nottysukku/GrassKit_Rover/16_RaceCar_MotorDriver_Bluetooth_Audio/docs/audio_architecture.md

# Audio Engine Architecture & Synthesis Theory

This document details the real-time audio synthesis engine developed for the **STM32L073RZ** and **MAX98357A** Class-D amplifier.

---

## 1. Hardware Constraints on STM32L073RZ

The STM32L073RZ features an **ARM Cortex-M0+ core at 32 MHz** with **20 KB of SRAM** and no floating-point hardware (FPU).
These constraints make conventional approaches infeasible:
- Loading multi-megabyte MP3/WAV samples into RAM is impossible (RAM is only 20 KB).
- Floating-point `sin()` or DSP polynomial evaluations inside an audio interrupt would overload the 32 MHz CPU.

### Solution: Procedural Fixed-Point Audio Engine with I2S DMA
Our procedural synthesizer overcomes these limits:
1. **Zero-Overhead Streaming**: DMA1 Channel 5 handles continuous I2S transmission in circular ping-pong mode. The CPU only wakes up twice per buffer period (every 8 ms @ 16 kHz).
2. **Fixed-Point Arithmetic**: Frequency calculations and phase updates use 32-bit integer arithmetic with lookup tables.
3. **RAM Footprint**: The entire audio subsystem requires only **1024 bytes** of SRAM for the ping-pong DMA buffer.
4. **CPU Load**: Benchmark tests show synthesis takes less than **0.25 ms per 8 ms block**, representing **< 3.5% CPU utilization**!

---

## 2. Acoustic Physics of the V8 Engine Sound Model

The sound produced by an internal combustion engine is primarily governed by periodic high-pressure exhaust pulses exiting the cylinders:

$$\text{Combustion Frequency } F_c = \frac{\text{RPM}}{60} \times \frac{\text{Cylinders}}{2}$$

For a cross-plane V8 engine (8 cylinders), there are 4 combustion events per crankshaft revolution:
- **Idle (900 RPM)**: $F_c = \frac{900}{60} \times 4 = 60 \text{ Hz}$ (deep, throaty thrum)
- **Mid-Range (3600 RPM)**: $F_c = \frac{3600}{60} \times 4 = 240 \text{ Hz}$ (energetic roar)
- **Redline (7200 RPM)**: $F_c = \frac{7200}{60} \times 4 = 480 \text{ Hz}$ (high-pitched racing scream)

---

## 3. Multi-Layer Sound Synthesis Architecture

```text
  Engine Model (RPM, Throttle, Gear, Turbo, Rev Limit)
                      │
                      ▼
 ┌─────────────────────────────────────────────────────────┐
 │               Procedural Sound Generator                │
 │                                                         │
 │  [Phase Acc 1] ──► [256-point Asymmetric Pulse LUT]     │ (Fundamental Firing)
 │  [Phase Acc 2] ──► [Crankshaft Subharmonic 0.5x]        │ (Mechanical Thrum)
 │  [Phase Acc 3] ──► [Manifold Resonance 2x]              │ (Acoustic Ringing)
 │                                                         │
 │  [Linear Congruential Noise Gen]                        │
 │        ├── Load-dependent Intake Induction Roar         │ (Throttle Modulated)
 │        ├── Turbo Blow-Off Valve (BOV) Hiss              │ (Decay Envelope)
 │        └── Overrun Exhaust Crackles & Burble            │ (Anti-lag Pops)
 │                                                         │
 │  [Rev Limiter Gate] ──► 16 Hz Staccato Ignition Chop    │
 │  [Gear Shift Cut]   ──► 120 ms 75% Gain Dip             │
 └────────────────────────────┬────────────────────────────┘
                              │
                              ▼ 16-bit PCM @ 16 kHz
 ┌─────────────────────────────────────────────────────────┐
 │               I2S2 + DMA1 Double Buffer                 │
 │  Half-Buffer 0: 128 Stereo Samples                      │
 │  Half-Buffer 1: 128 Stereo Samples                      │
 └────────────────────────────┬────────────────────────────┘
                              │
                              ▼ Digital I2S Bus
                     MAX98357A Class-D Amp ──► Speaker
```

---

## 4. Special Sound Effects Implementation

1. **Intake Induction Roar**:
   As physical throttle increases from 0% to 100%, an envelope blends bandpass pseudorandom noise into the fundamental wave, replicating the deep acoustic growl of an open throttle body.
2. **Exhaust Overrun Pops (Anti-Lag)**:
   When throttle is rapidly closed from above 3500 RPM, unburned fuel entering the virtual exhaust manifold ignites, creating random, high-amplitude transient crackles (`Audio_TriggerOverrunPop()`).
3. **Turbo Blow-Off Valve (BOV)**:
   When boost pressure exceeds 0.45 bar and the throttle is released, a white-noise burst with an exponential low-pass filter decay is played to emulate a turbocharger wastegate/blow-off valve.
4. **Rev Limiter Bark**:
   When RPM reaches 7000 RPM, the fuel-cut algorithm gates the output at 16 Hz, producing the signature bouncing limiter bark heard on racing cars.
