nottysukku/GrassKit_Rover/17_Rover_MotorDriver_WiFi_ST67W61/docs/rbt01a_sheet_b_logic_wires.png

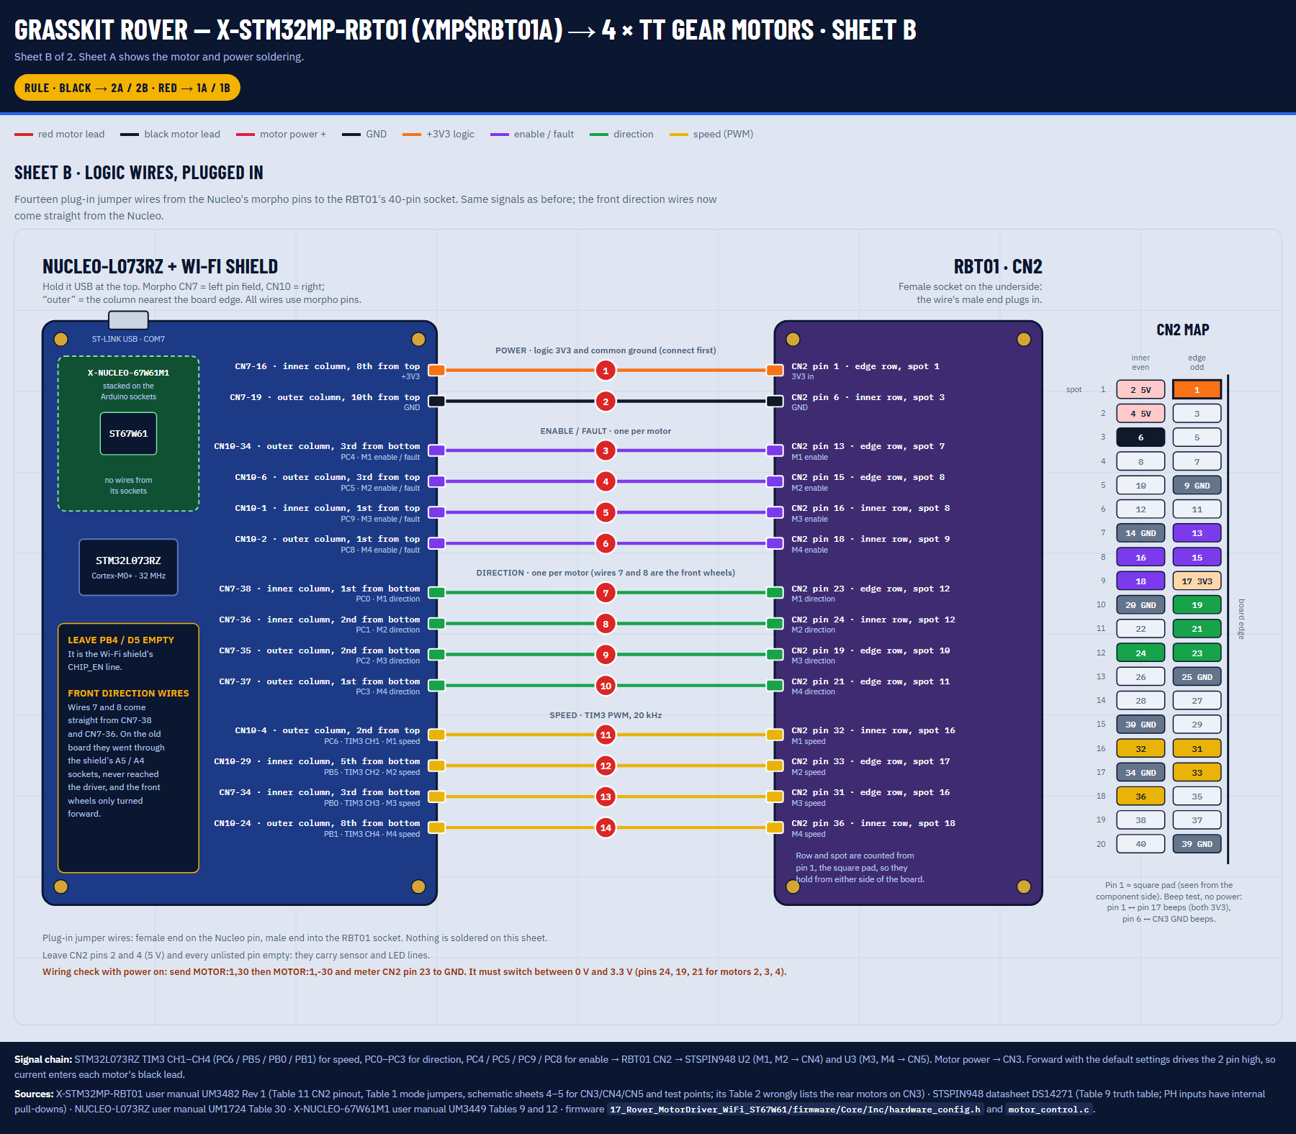
17_Rover_MotorDriver_WiFi_ST67W61/docs/rbt01a_sheet_b_logic_wires.png
