nottysukku/GrassKit_Rover/18_Rover_Chassis_OpenSCAD/renders/v3_lid_lifted.png

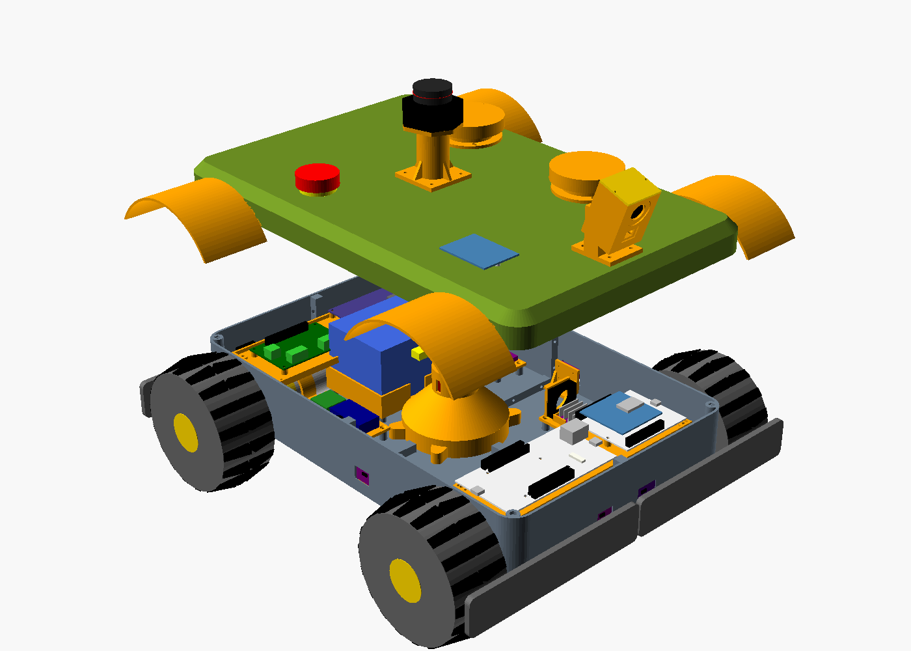
18_Rover_Chassis_OpenSCAD/renders/v3_lid_lifted.png
