nottysukku/GrassKit_Rover/18_Rover_Chassis_OpenSCAD/renders/v3_top_no_lid.png

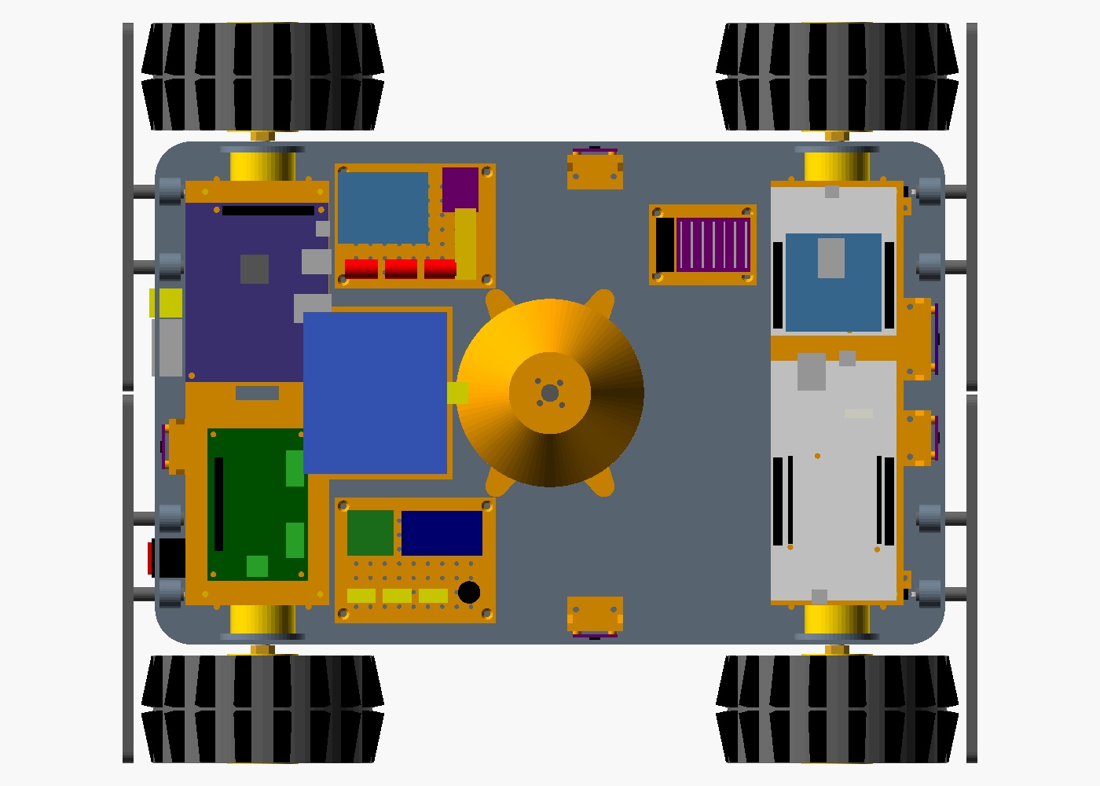
18_Rover_Chassis_OpenSCAD/renders/v3_top_no_lid.png
