nottysukku/GrassKit_Rover/18_Rover_Chassis_OpenSCAD/renders/v3_underside.png

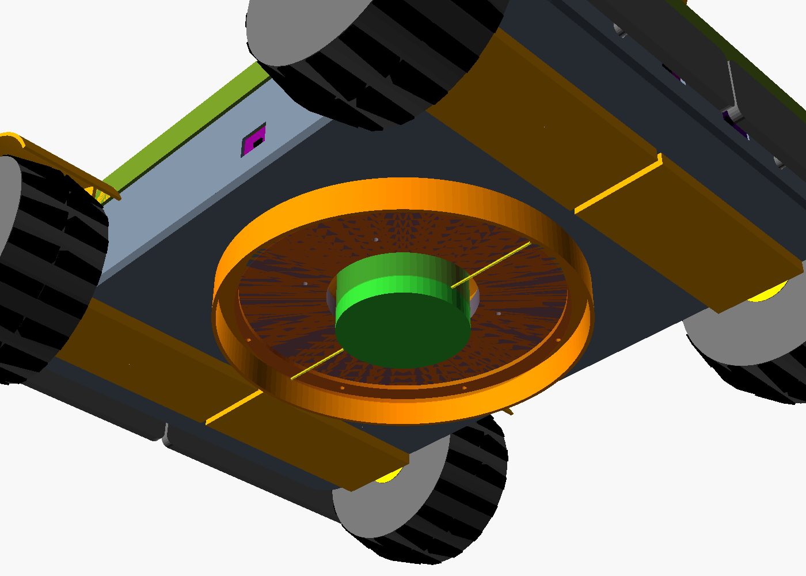
18_Rover_Chassis_OpenSCAD/renders/v3_underside.png
