nottysukku/GrassKit_Rover/documentation/00_Project_Status/GrassKit_Rover_Final_BOM_2026-11-04.xlsx

Sheet: Summary
GrassKit Rover - final bill of materials (2 rovers)
Prices in INR incl. GST where the shop shows it. 'Listed' = seen on the shop page Nov 2026; 'Est.' = estimate. Verify each price and stock before ordering.
Inputs
Rovers to build | 2 | Edit the yellow cells. Blue text on the BOM sheet = editable inputs (qty, have, price).
Contingency (shipping, breakage, price changes) | 10%
Totals
 | To order (INR) | Note
All items (to order, before contingency) |  | Sum of BOM column L
Contingency |  | C7 x total
Grand total incl. contingency
Must-have items only |  | Minimum viable order
Must + Should
ST kits (ask via IRIS / ST samples first) |  | May cost the team nothing if sourced internally
Bought from shops (non-ST kits) |  | Out-of-pocket if ST kits come free
Cost to build ONE rover at list price |  | Qty/rover x unit price, ignores owned parts and spares
One rover, shop-bought parts only |  | Closer to a production cost
By category
Category | To order (INR) | Share
1 Compute & control (ST)
2 Sensors
3 Drive
4 Cutter
5 Power & protection
6 Wiring & EMC
7 Chassis & enclosure
8 Tools & safety (shared)
Total
Final design decisions
- Drive: skid-steer on 130 mm treaded wheels with 36 mm planetary gearmotors + encoders (mecanum rollers slip on grass).
- Cutter: brushless outrunner + ST B-G431B-ESC1 (FOC). No brushes to wear, no brush arcing (Wi-Fi noise), and the ESC reports speed + current for line / motor wear checks.
- Compute: STM32MP257F-DK (Linux, ROS 2, SLAM, planning) + NUCLEO-N657X0-Q (camera AI) + NUCLEO-G474RE (real-time control, micro-ROS) + X-STM32MP-RBT01 + X-NUCLEO-67W61M1.
- Power: one 4S 14.8 V 10 Ah Li-ion pack. XT90-S -> main switch -> E-stop relay -> fused branches; TVS on the bus, ESD arrays on every external connector.
- Sensors: LD19 DTOF lidar (sunlight rated), VL53L9 3D dToF front, 4x VL53L8CX safety ring, RBT01 IMU + magnetometer, wheel encoders, bumpers, lift sensor.
- Chassis: fully 3D-printed tub + lid (8 quarters, fits a 250 x 210 mm bed) from the OpenSCAD model 18_Rover_Chassis_OpenSCAD v3, which matches this BOM. The body is the enclosure, so there is no metal deck, canopy sheet or IP65 box.

Sheet: BOM
# | Category | Item | Part / specification | Purpose (why it is on the rover) | Qty per rover | Extra / spares (project) | Total qty | Already have | To order | Unit price (INR) | Order cost (INR) | Priority | Price basis | Source type | Buy from | Link | Alternate link | Notes / check before ordering
1 | 1 Compute & control (ST) | Navigation computer | STM32MP257F-DK (STM32MP257F, 2x Cortex-A35 + Cortex-M33, NPU, 4 GB DDR4) | Runs Linux + ROS 2: lidar SLAM, lawn map, zone split, coverage path planning, micro-ROS agent | 1 | 0 |  | 0 |  | 13500 |  | Must | Est. (RS UK GBP 112.76 + duty) | ST kit | Mouser India | https://www.mouser.in/c/?q=STM32MP257F-DK | https://www.st.com/en/evaluation-tools/stm32mp257f-dk.html | RBT01 is also compatible with this board's 40-pin header (DB5412) - useful fallback if the G474 path slips.
2 | 1 Compute & control (ST) | microSD card for MP2 | 32 GB microSD, UHS-I A1 (SanDisk / Samsung) | Boot disk for OpenSTLinux + ROS 2 on the STM32MP257F-DK | 1 | 1 |  | 0 |  | 500 |  | Must | Est. | Buy | Amazon.in | https://www.amazon.in/s?k=32GB+microSD+A1+UHS-I | https://robu.in/?s=32GB+micro+SD+card&post_type=product
3 | 1 Compute & control (ST) | Perception MCU | NUCLEO-N657X0-Q (STM32N657, Cortex-M55 + Neural-ART NPU) | Camera AI at the edge: grass / obstacle / person detection, fuses ToF depth; publishes results as a micro-ROS node | 1 | 0 |  | 0 |  | 6945 |  | Must | Listed: Mouser India Rs 6,944.71 | ST kit | Mouser India | https://www.mouser.in/c/?q=NUCLEO-N657X0-Q | https://www.st.com/en/evaluation-tools/nucleo-n657x0-q.html | Set 'Have' if the team already received N6 boards (Nov plan uses STM32N657).
4 | 1 Compute & control (ST) | Camera for N6 | B-CAMS-IMX (Sony IMX335 5 MP MIPI CSI-2 module + ST ToF) | Sees the lawn edge, flower beds, people and pets for the N6 vision model | 1 | 0 |  | 0 |  | 4500 |  | Must | Est. | ST kit | ST eStore | https://estore.st.com/en/b-cams-imx-cpn.html | https://www.st.com/en/evaluation-tools/b-cams-imx.html
5 | 1 Compute & control (ST) | Motion & safety MCU | NUCLEO-G474RE (STM32G474, 170 MHz Cortex-M4F, 128 KB RAM) | Real-time loop: 4 encoders, PWM to RBT01, cutter ESC command, E-stop/bump/lift inputs, Wi-Fi link; micro-ROS client | 1 | 1 |  | 0 |  | 2200 |  | Must | Est. | ST kit | Mouser India | https://www.mouser.in/c/?q=NUCLEO-G474RE | https://www.st.com/en/evaluation-tools/nucleo-g474re.html | Replaces NUCLEO-L073RZ (20 KB RAM is too small for micro-ROS + 4 encoders). Same Nucleo-64 headers, so the shield and RBT01 wiring carry over (pins re-mapped).
6 | 1 Compute & control (ST) | Drive motor board | X-STM32MP-RBT01 (2x STSPIN948, ISM330DHCX IMU, IIS2MDC mag, LPS22HH, VL53L5CX) | Drives the 4 wheel motors (max 2.5 A each, up to 48 V); onboard IMU + magnetometer give heading for odometry | 1 | 1 |  | 1 |  | 6000 |  | Must | Est. | ST kit | ST (via IRIS / sales office) | https://www.st.com/en/evaluation-tools/x-stm32mp-rbt01.html | https://www.mouser.in/c/?q=X-STM32MP-RBT01 | 1 owned (check after the 2026-11-02 probe-slip: 3V3/VS short test). Spare because of that damage.
7 | 1 Compute & control (ST) | Wi-Fi 6 / BLE radio | X-NUCLEO-67W61M1 (ST67W611M1 Wi-Fi 6 + BLE 5.4) | Phone control page, rover-to-rover zone sharing and heartbeat; link loss stops the rover | 1 | 0 |  | 1 |  | 2600 |  | Must | Est. | ST kit | ST eStore | https://estore.st.com/en/x-nucleo-67w61m1-cpn.html | https://www.mouser.in/c/?q=X-NUCLEO-67W61M1 | 1 owned. Module needs NCP firmware v2.0.106 (T01) before use.
8 | 1 Compute & control (ST) | Cutter motor drive (ESC) | B-G431B-ESC1 (STM32G431 FOC ESC, 3S-6S, 40 A peak) | Speed-controlled FOC drive for the BLDC cutter; reports speed + current used for line and motor wear checks | 1 | 1 |  | 0 |  | 2100 |  | Must | Est. | ST kit | Mouser India | https://www.mouser.in/new/stmicroelectronics/stm-b-g431b-esc1-discovery-kit/ | https://www.st.com/en/evaluation-tools/b-g431b-esc1.html | Program with X-CUBE-MCSDK (Motor Control Workbench). 40 A peak assumes airflow - fit the heatsink + fan below.
9 | 2 Sensors | 360 deg lidar | LDRobot LD19 / STL-19P DTOF lidar, 12 m, 4.5 kHz, 30 klux sunlight rated | Outdoor SLAM and obstacle map around the rover (DTOF works in sunlight, unlike triangulation lidars) | 1 | 0 |  | 0 |  | 7800 |  | Must | Listed: Rs 7,541-9,628 (Rees52 / Robotools) | Buy | Robu.in | https://robu.in/?p=1300098 | https://robotools.in/shop/sensor/lidar-sensor/ldrobot-dtof-ld19-laser-ranging-sensor-360-omni-directional-lidar-uart-bus-with-12m-range | Robu showed out of stock (restock 25-30 days) - order early or use Robotools. ROS 2 driver: ldlidar_stl_ros2. Alt: RPLIDAR C1.
10 | 2 Sensors | 3D depth sensor | STEVAL-VL53L9 (VL53L9CX dToF, 2.3k zones, 55 x 42 deg, up to 9 m) | Front 3D scan of grass height, edges and low obstacles for the lawn map | 1 | 0 |  | 0 |  | 8000 |  | Should | Est. (preview part) | ST kit | Mouser India | https://www.mouser.in/new/stmicroelectronics/stmicroelectronics-steval-vl53l9-eval-board/ | https://www.st.com/en/evaluation-tools/steval-vl53l9.html | Still a preview product at ST - request samples via IRIS. Fallback: the VL53L5CX on the RBT01 + the VL53L8CX ring below.
11 | 2 Sensors | Near-field ToF ring | VL53L8CX 8x8 multizone ToF breakout (SATEL-VL53L8) | Front / rear / left / right safety ring: stops the cutter for low objects the lidar plane misses (toys, pets) | 4 | 1 |  | 0 |  | 1600 |  | Must | Est. per board | ST kit | Mouser India | https://www.mouser.in/c/?q=SATEL-VL53L8 | https://www.st.com/en/evaluation-tools/satel-vl53l8.html | Check whether one SATEL pack holds 1 or 2 boards; order enough for 4 boards per rover. Matches the 4 ToF brackets in the SCAD.
12 | 2 Sensors | GNSS receiver (optional) | X-NUCLEO-GNSS1A1 (Teseo-LIV3F, GPS/Galileo/GLONASS/BeiDou) | Geofence and map geo-referencing; corrects slow heading drift on long lawns | 1 | 0 |  | 0 |  | 3000 |  | Optional | Est. | ST kit | Mouser India | https://www.mouser.in/c/?q=X-NUCLEO-GNSS1A1 | https://www.st.com/en/evaluation-tools/x-nucleo-gnss1a1.html | ~1.5 m accuracy - helper only, the plan stays wire-free and RTK-free.
13 | 2 Sensors | Battery monitor | INA226 I2C current / voltage monitor module (36 V) with 2 mOhm shunt | Battery voltage, current and energy used per run; low-battery return trigger | 1 | 1 |  | 0 |  | 350 |  | Should | Est. | Buy | Robu.in | https://robu.in/?s=INA226+module&post_type=product | https://www.amazon.in/s?k=INA226+current+sensor+module
14 | 2 Sensors | Bumper switches | Micro limit switch with roller lever (KW12 / V-156) | Mechanical bumper: last line of defence if ToF/lidar miss an obstacle | 4 | 4 |  | 0 |  | 30 |  | Must | Est. | Buy | Robu.in | https://robu.in/?s=micro+limit+switch+roller+lever&post_type=product | https://www.amazon.in/s?k=micro+limit+switch+roller+lever
15 | 2 Sensors | Lift / tilt sensor | A3144 / SS49E Hall sensor + 6x3 mm neodymium magnet | Detects the floating canopy being lifted; stops the cutter (with IMU tilt check on the RBT01) | 2 | 2 |  | 0 |  | 60 |  | Must | Est. | Buy | Robu.in | https://robu.in/?s=hall+effect+sensor+A3144&post_type=product | https://robu.in/?s=neodymium+magnet+6x3&post_type=product
16 | 2 Sensors | Rain sensor (optional) | FC-37 / YL-83 rain sensor board + comparator | Pause mowing when it rains (wet grass clogs and the electronics are not sealed for rain) | 1 | 0 |  | 0 |  | 100 |  | Optional | Est. | Buy | Robu.in | https://robu.in/?s=rain+sensor+module&post_type=product | https://www.amazon.in/s?k=rain+sensor+module+FC-37
17 | 2 Sensors | Temperature sensors | 10 kOhm NTC thermistor, epoxy bead (pack of 10) | Cutter motor, drive motor and battery temperature for wear / overheat alarms | 1 | 0 |  | 0 |  | 150 |  | Should | Est. | Buy | Robu.in | https://robu.in/?s=10k+NTC+thermistor&post_type=product | https://www.amazon.in/s?k=10k+NTC+thermistor+pack
18 | 3 Drive | Drive gearmotor | Planetary gearmotor 36 mm, 12 V, ~100 RPM (~51:1), >=15 kg.cm rated, AB Hall encoder | Moves the rover on grass and 15 deg slopes; encoder ticks feed wheel odometry | 4 | 2 |  | 0 |  | 2000 |  | Must | Est. | Buy | Robu.in (Pro-Range PG36M555) | https://robu.in/?s=PG36M555+planetary&post_type=product | https://robodo.in/products/36mm-planetary-gear-motor-100-rpm-12v-dc-high-torque | Confirm the encoder is included (else add an AB Hall encoder for 555 motors). Keep stall below the RBT01 2.5 A/motor limit via firmware current limit. 12 V motor on 4S: cap PWM ~75 %.
19 | 3 Drive | Wheel | 130 x 60 mm off-road rubber wheel, 12 mm hex hub | Treaded tyres for grip on grass (mecanum rollers slip); 130 mm keeps the deck high enough for a 40 mm cut | 4 | 2 |  | 0 |  | 750 |  | Must | Listed: Rs 640-1,340 (ThinkRobotics) | Buy | Indian Hobby Center | https://indianhobbycenter.com/products/130mm-robot-wheel-for-atv-and-diy-robotics | https://thinkrobotics.com/products/130mm-wheel-set-with-mounting-brackets
20 | 3 Drive | Wheel hub coupling | Brass hex coupling, 12 mm hex outside, bore to match motor shaft (8 mm for PG36), 18 mm long | Joins the gearmotor shaft to the wheel hub | 4 | 2 |  | 0 |  | 150 |  | Must | Est. | Buy | Robu.in | https://robu.in/?p=699516 | https://robu.in/?s=hex+coupling+robot+wheel&post_type=product | Check the motor shaft (8 mm D on most 36 mm planetaries, 6 mm on JGB37) before ordering.
21 | 3 Drive | Motor bracket | L-bracket for 36 mm planetary gearmotor (steel, M3 face screws) | Fallback only: holds a motor if the printed wall pads of chassis v3 flex | 0 | 0 |  | 0 |  | 250 |  | Optional | Est. | Buy | Robu.in | https://robu.in/?s=36mm+planetary+motor+mounting+bracket&post_type=product | https://www.amazon.in/s?k=36mm+gear+motor+mounting+bracket | Not needed for chassis v3: each gearbox face bolts to a 6 mm printed wall pad and a printed clamp holds the motor from above. Buy only if the pads flex in testing.
22 | 3 Drive | Motor noise capacitors | 100 nF 50 V X7R ceramic capacitors (pack of 100) | 3 per motor (across terminals + each terminal to case): cuts brush noise that desenses Wi-Fi | 0 | 1 |  | 0 |  | 150 |  | Must | Est. | Buy | Robu.in | https://robu.in/?s=100nF+ceramic+capacitor&post_type=product | https://www.amazon.in/s?k=104+ceramic+capacitor+50V+pack
23 | 3 Drive | Clip-on ferrite cores | Snap-on ferrite, 5-7 mm cable (pack of 10) | On motor leads and the logic power lead: blocks motor PWM / brush noise from reaching the Wi-Fi module | 1 | 0 |  | 0 |  | 350 |  | Must | Est. | Buy | Amazon.in | https://www.amazon.in/s?k=clip+on+ferrite+core+7mm+pack+of+10 | https://robu.in/?s=ferrite+core&post_type=product
24 | 4 Cutter | Cutter motor (BLDC) | DYS D3536-8 1000 KV brushless outrunner | Spins the line head at 6,000-8,000 rpm under FOC speed control; no brushes to wear and no brush arcing noise | 1 | 1 |  | 0 |  | 1482 |  | Must | Listed: Robu Rs 1,482 | Buy | Robu.in | https://robu.in/?p=1115428 | https://robu.in/?s=3536+brushless+motor&post_type=product | 1000 KV x 14.8 V = 14,800 rpm no-load; the ESC speed loop holds ~7,000 rpm. Chassis v3 hangs it shaft-down from the cutter tower top plate (X-mount).
25 | 4 Cutter | Spool-head adapter | Aluminium hub: motor X-mount to M8 x 1.25 left-hand arbor (match your spool thread) | Connects the outrunner to the trimmer spool head | 1 | 1 |  | 0 |  | 600 |  | Must | Est. (local machinist) | Buy | Local machine shop |  |  | Measure the spool thread first (M8 or M10, usually left-hand). A printed version is fine for first tests only.
26 | 4 Cutter | Trimmer spool head | Universal bump-feed spool head with M8 / M10 LH adapters | Holds the nylon line (the GIGAWATTS head can be reused on rover 1) | 1 | 1 |  | 1 |  | 450 |  | Must | Est. | Buy | Amazon.in | https://www.amazon.in/s?k=universal+trimmer+bump+feed+spool+head | https://www.amazon.in/s?k=grass+trimmer+spool+head+replacement | 1 owned (from the GIGAWATTS 250 W trimmer).
27 | 4 Cutter | Trimmer line | Nylon trimmer line 1.6 mm round, 15 m | Cutting line; wears down in use, so spares are on the list | 1 | 2 |  | 0 |  | 300 |  | Must | Est. | Buy | Amazon.in | https://www.amazon.in/s?k=trimmer+line+1.6mm+15m | https://www.amazon.in/s?k=nylon+grass+trimmer+line
28 | 4 Cutter | Blade disc (optional) | Robot-mower pivoting razor blades (set of 9) + printed / aluminium 3-blade disc | Alternative cutting head: less power than line, blades fold back on impact, wear is easy to see | 1 | 0 |  | 0 |  | 1200 |  | Optional | Est. | Buy | Amazon.in | https://www.amazon.in/s?k=robotic+lawn+mower+replacement+blades |  | Try if line wear or power draw is too high in testing.
29 | 4 Cutter | ESC cooling | Aluminium heatsink + 30 mm 5 V fan | Keeps the B-G431B-ESC1 cool inside the canopy (no propeller airflow on a mower) | 1 | 0 |  | 0 |  | 250 |  | Must | Est. | Buy | Robu.in | https://robu.in/?s=30mm+5V+fan&post_type=product | https://robu.in/?s=aluminium+heatsink&post_type=product
30 | 5 Power & protection | Battery pack | Pro-Range 14.8 V 10 Ah 4S4P Li-ion pack (NMC 18650, 3C, protected) | One pack runs wheels, cutter and electronics (~148 Wh, ~50 min mowing - see Design basis) | 1 | 1 |  | 0 |  | 3459 |  | Must | Listed: Robu Rs 3,459 (SKU 1396412) | Buy | Robu.in | https://robu.in/?p=1396412 | https://robu.in/?p=514766 | Spare = swap pack. Confirm BMS + XT60 on the live page. Alt link = 7.5 Ah 4S3P.
31 | 5 Power & protection | Charger | 16.8 V 3 A Li-ion charger for 4S packs | Charges the 4S pack (CC/CV, auto cut-off) | 1 | 0 |  | 0 |  | 900 |  | Must | Est. | Buy | Robu.in | https://robu.in/?s=16.8V+3A+Li-ion+charger&post_type=product | https://www.amazon.in/s?k=16.8V+3A+lithium+battery+charger
32 | 5 Power & protection | Anti-spark connector | XT90-S anti-spark connector pair | Main battery plug: keyed (no reverse polarity) and stops the plug-in spark / inrush | 1 | 2 |  | 0 |  | 250 |  | Must | Est. | Buy | Robu.in | https://robu.in/?s=XT90+anti+spark&post_type=product | https://www.amazon.in/s?k=XT90S+anti+spark+connector
33 | 5 Power & protection | Branch connectors | XT60 connector pairs (pack of 5) | Keyed connectors for the drive, cutter and logic branches | 1 | 0 |  | 0 |  | 250 |  | Must | Est. | Buy | Robu.in | https://robu.in/?s=XT60+connector+pair&post_type=product | https://www.amazon.in/s?k=XT60+connector+pair+pack
34 | 5 Power & protection | Main switch | DC rocker / toggle switch, 30 A | Turns the whole rover on and off | 1 | 1 |  | 0 |  | 250 |  | Must | Est. | Buy | Robu.in | https://robu.in/?s=30A+DC+switch&post_type=product | https://www.amazon.in/s?k=30A+DC+toggle+switch
35 | 5 Power & protection | Emergency stop | 22 mm mushroom-head latching E-stop, 1 NC contact | Red button on the canopy: cuts wheels and cutter at once | 1 | 1 |  | 0 |  | 350 |  | Must | Est. | Buy | Robu.in | https://robu.in/?s=emergency+stop+switch+22mm&post_type=product | https://www.amazon.in/s?k=22mm+emergency+stop+mushroom+switch
36 | 5 Power & protection | Power relay | 1-channel 5 V 30 A relay module | E-stop opens the coil, MCU can also drop it: motor power off, logic stays on to report the fault | 1 | 1 |  | 0 |  | 250 |  | Must | Est. | Buy | Robu.in | https://robu.in/?s=5V+30A+relay+module&post_type=product | https://www.amazon.in/s?k=5V+30A+relay+module
37 | 5 Power & protection | Fuses | Waterproof inline blade-fuse holders x3 + ATC fuse kit (5/10/15/20 A) | One fuse per branch: 20 A cutter, 10 A drive (RBT01 also has F1 15 A), 5 A logic | 1 | 0 |  | 0 |  | 450 |  | Must | Est. | Buy | Amazon.in | https://www.amazon.in/s?k=inline+blade+fuse+holder+waterproof | https://www.amazon.in/s?k=ATC+blade+fuse+kit
38 | 5 Power & protection | 5 V logic regulator | Pololu D36V50F5 5 V 5.5 A step-down (6-50 V in) | Clean 5 V for Nucleo boards, ToF, lidar and the Wi-Fi shield | 1 | 0 |  | 0 |  | 2700 |  | Should | Est. | Buy | Robu.in | https://robu.in/?s=Pololu+D36V50F5&post_type=product | https://www.pololu.com/search?query=D36V50F5 | Cheaper alt: XL4015 5 A buck + the LC filter below (noisier).
39 | 5 Power & protection | MP2 supply | USB-C 5 V 3 A step-down (12-24 V in) | Dedicated supply for the STM32MP257F-DK so Linux never browns out when the cutter starts | 1 | 0 |  | 0 |  | 700 |  | Must | Est. | Buy | Amazon.in | https://www.amazon.in/s?k=12V+to+5V+3A+USB+type+C+step+down+converter | https://robu.in/?s=USB+type+C+buck+converter+5V+3A&post_type=product
40 | 5 Power & protection | Bulk / filter capacitors | Low-ESR electrolytics: 1000 uF 35 V x5, 470 uF 25 V x5 + ferrite beads | 1000 uF at the ESC and RBT01 inputs; LC filter on the 5 V logic rail | 1 | 0 |  | 0 |  | 300 |  | Must | Est. | Buy | Robu.in | https://robu.in/?s=1000uF+35V+low+ESR&post_type=product | https://robu.in/?s=ferrite+bead&post_type=product
41 | 5 Power & protection | TVS diode (bus) | ST SM15T22A, 1500 W, 18.8 V stand-off, unidirectional | Clamps motor-switching and ESD spikes on the 16.8 V battery bus | 2 | 4 |  | 0 |  | 40 |  | Must | Est. | ST part | Mouser India | https://www.mouser.in/c/?q=SM15T22A | https://www.digikey.in/en/products/result?keywords=SM15T22A
42 | 5 Power & protection | ESD protection (signals) | ST USBLC6-2SC6, 2-line ESD array, SOT-23-6 | At every external connector (encoders, bumpers, ToF cables, USB): absorbs ESD from handling and grass static | 6 | 6 |  | 0 |  | 30 |  | Must | Est. | ST part | Mouser India | https://www.mouser.in/c/?q=USBLC6-2SC6 | https://www.digikey.in/en/products/result?keywords=USBLC6-2SC6
43 | 5 Power & protection | SOT-23-6 adapters | SOT-23-6 to DIP adapter PCBs (pack of 10) | Lets the ESD arrays be soldered by hand onto perfboard / connector boards | 0 | 2 |  | 0 |  | 150 |  | Must | Est. | Buy | Robu.in | https://robu.in/?s=SOT23-6+to+DIP+adapter&post_type=product | https://www.amazon.in/s?k=SOT23+to+DIP+adapter+board
44 | 6 Wiring & EMC | Power wire 12 AWG | Silicone wire 12 AWG, 3 m red + 3 m black | Battery, relay and cutter runs (up to ~20 A) | 1 | 0 |  | 0 |  | 600 |  | Must | Est. | Buy | Robu.in | https://robu.in/?s=12AWG+silicone+wire&post_type=product | https://www.amazon.in/s?k=12+AWG+silicone+wire+red+black
45 | 6 Wiring & EMC | Motor wire 18 AWG | Silicone wire 18 AWG, 5 m red + 5 m black | Drive motor leads (twist each pair to cut radiated noise) | 1 | 0 |  | 0 |  | 450 |  | Must | Est. | Buy | Robu.in | https://robu.in/?s=18AWG+silicone+wire&post_type=product | https://www.amazon.in/s?k=18+AWG+silicone+wire
46 | 6 Wiring & EMC | Signal wire | 22 / 24 AWG hook-up wire kit, 6 colours | Signal wiring between boards | 0 | 1 |  | 0 |  | 600 |  | Must | Est. | Buy | Amazon.in | https://www.amazon.in/s?k=22+AWG+hook+up+wire+kit | https://robu.in/?s=hook+up+wire+kit&post_type=product
47 | 6 Wiring & EMC | Shielded cable | 4-core shielded cable (2 twisted pairs), 10 m | Encoder and ToF/I2C runs; shield grounded at the MCU end only | 1 | 0 |  | 0 |  | 700 |  | Must | Est. | Buy | Amazon.in | https://www.amazon.in/s?k=4+core+shielded+cable+10m | https://robu.in/?s=shielded+cable+4+core&post_type=product
48 | 6 Wiring & EMC | Connector kit | JST-XH + JST-PH + Dupont assortment with crimp terminals | Board-to-board and sensor connectors | 0 | 1 |  | 0 |  | 900 |  | Must | Est. | Buy | Amazon.in | https://www.amazon.in/s?k=JST+XH+JST+PH+dupont+connector+kit+crimp | https://robu.in/?s=JST+connector+kit&post_type=product
49 | 6 Wiring & EMC | Heat-shrink kit | Heat-shrink tube assortment | Insulates joints | 0 | 1 |  | 0 |  | 350 |  | Must | Est. | Buy | Amazon.in | https://www.amazon.in/s?k=heat+shrink+tube+assortment | https://robu.in/?s=heat+shrink+kit&post_type=product
50 | 6 Wiring & EMC | Cable management | Cable ties, spiral wrap, adhesive tie mounts, hook-and-loop battery strap | Keeps wires off the cutter and away from the antenna | 1 | 0 |  | 0 |  | 300 |  | Must | Est. | Buy | Amazon.in | https://www.amazon.in/s?k=cable+ties+spiral+wrap+adhesive+mounts+kit
51 | 6 Wiring & EMC | Lever connectors | Wago 221 lever connectors (pack of 20) | Quick, tool-free joints on the 5 V and ground distribution | 0 | 1 |  | 0 |  | 700 |  | Should | Est. | Buy | Amazon.in | https://www.amazon.in/s?k=Wago+221+lever+connector+pack
52 | 6 Wiring & EMC | Star-ground bus | 6-way ground bus bar / terminal block | Single star ground point: motor currents do not flow through logic grounds | 1 | 0 |  | 0 |  | 200 |  | Must | Est. | Buy | Amazon.in | https://www.amazon.in/s?k=6+way+ground+bus+bar | https://robu.in/?s=terminal+block+6+way&post_type=product
53 | 7 Chassis & enclosure | Window covers | 1 mm clear polycarbonate sheet, A4 | Covers behind the 5 ToF windows and in front of the camera lens, glued into recesses in the printed body | 0 | 1 |  | 0 |  | 250 |  | Must | Est. | Buy | Amazon.in | https://www.amazon.in/s?k=clear+polycarbonate+sheet+1mm+A4 |  | One A4 sheet covers both rovers. Use thin, clean, uncoated covers and run the VL53L8CX / VL53L9 crosstalk calibration with the cover fitted.
54 | 7 Chassis & enclosure | Lid magnets | 6 x 3 mm N52 neodymium disc magnets (pack of 20) | Hold the floating lid on the tub (2 pairs per rover) | 0 | 1 |  | 0 |  | 250 |  | Must | Est. | Buy | Amazon.in | https://www.amazon.in/s?k=6x3mm+neodymium+magnet | https://robu.in/?s=6x3+neodymium+magnet&post_type=product | 4 per rover; item 15 already counts the 2 magnets for the Hall lift sensors. Glue in with epoxy and check the polarity before it sets.
55 | 7 Chassis & enclosure | PETG filament | PETG 1.75 mm, 1 kg | The whole printed body: tub + lid (8 quarters), motor trays and clamps, cutter tower, guard skirt, board decks, mounts, bumpers (about 2.7 kg per rover) | 3 | 1 |  | 0 |  | 1200 |  | Must | Est. | Buy | Robu.in | https://robu.in/?s=PETG+filament+1.75mm+1kg&post_type=product | https://www.amazon.in/s?k=PETG+filament+1.75mm+1kg | STLs and print table: 18_Rover_Chassis_OpenSCAD (README). 5 walls, 20 % gyroid. The body quarters need a 250 x 210 mm bed. ASA also works.
56 | 7 Chassis & enclosure | TPU filament | TPU 95A 1.75 mm, 1 kg | Optional softer guard skirt and bumper halves (both also print in PETG) | 0 | 1 |  | 0 |  | 1800 |  | Optional | Est. | Buy | Robu.in | https://robu.in/?s=TPU+filament+1.75mm&post_type=product | https://www.amazon.in/s?k=TPU+95A+filament+1.75mm
57 | 7 Chassis & enclosure | Bumper springs | Compression springs, about 9 mm ID x 15-20 mm long, 0.5-0.7 mm wire (assortment) | Push the 4 bumper halves out on their printed 8 mm pins (8 per rover) | 0 | 1 |  | 0 |  | 300 |  | Must | Est. | Buy | Amazon.in | https://www.amazon.in/s?k=compression+spring+assortment |  | Must slide over an 8 mm pin. Pick a soft one so a light push trips the bumper micro-switch (item 14).
58 | 7 Chassis & enclosure | Panel-mount ports | Panel-mount USB-C extension cable (30 cm) + XT60 panel-mount holder | Rear-wall ports: USB-C for flashing and debug, XT60 for charging without lifting the lid | 1 | 0 |  | 0 |  | 450 |  | Must | Est. | Buy | Amazon.in / Robu.in | https://www.amazon.in/s?k=panel+mount+USB+C+extension+cable | https://robu.in/?s=XT60+panel+mount&post_type=product | The rear-wall cut-outs are sized from estimates: check them against these parts before printing the rear tub quarters.
59 | 7 Chassis & enclosure | M3 fasteners | M3 screw / nut / washer kit (6-30 mm, stainless, incl. countersunk) | Most of the assembly | 1 | 0 |  | 0 |  | 600 |  | Must | Est. | Buy | Amazon.in | https://www.amazon.in/s?k=M3+stainless+screw+nut+kit | https://robu.in/?s=M3+screw+kit&post_type=product | Chassis v3 per rover: 33 M3 x 12 + nuts for the quarter joints, about 24 M3 x 10-20 for the motor trays and clamps, countersunk M3 for the gearbox faces and fenders, 8 M3 self-tappers for the bumper pins.
60 | 7 Chassis & enclosure | M2 / M2.5 screws | M2 + M2.5 self-tapping screw kit (6-12 mm) | Camera board and ToF boards (M2), LD19 lidar (M2.5) | 0 | 1 |  | 0 |  | 400 |  | Must | Est. | Buy | Amazon.in | https://www.amazon.in/s?k=M2+M2.5+self+tapping+screw+kit |  | Chassis v3 uses M3 everywhere else, including the cutter tower, so no M4 kit is needed.
61 | 7 Chassis & enclosure | Heat-set inserts | M3 brass heat-set inserts (pack of 100) | Threads in the printed body: about 120 per rover | 1 | 1 |  | 0 |  | 400 |  | Must | Est. | Buy | Amazon.in | https://www.amazon.in/s?k=M3+brass+heat+set+inserts | https://robu.in/?s=M3+heat+set+insert&post_type=product | Chassis v3 per rover: 42 floor bosses, 12 cutter tower + guard skirt, 24 motor trays, 14 board bosses, 24 lid. Holes are 4.0 mm x 6 mm deep: buy M3 x 5.7 mm knurled inserts.
62 | 7 Chassis & enclosure | Standoffs | M3 x 35 brass hex standoffs, female-female (pack of 10) | Hold the two board decks above the drive motors (8 per rover) | 1 | 0 |  | 0 |  | 300 |  | Must | Est. | Buy | Amazon.in | https://www.amazon.in/s?k=M3+35mm+brass+hex+standoff+female | https://robu.in/?s=M3+35mm+standoff&post_type=product | The boards sit on printed bosses with heat-set inserts, so no short standoffs are needed.
63 | 7 Chassis & enclosure | Vibration mounts | Rubber grommets / anti-vibration dampers (pack) | Isolates the lidar mast from cutter vibration | 1 | 0 |  | 0 |  | 200 |  | Should | Est. | Buy | Amazon.in | https://www.amazon.in/s?k=rubber+anti+vibration+damper+M3
64 | 7 Chassis & enclosure | Conformal coating | Acrylic PCB conformal coating spray | Protects boards from dew and grass moisture | 0 | 1 |  | 0 |  | 900 |  | Should | Est. | Buy | Amazon.in | https://www.amazon.in/s?k=PCB+conformal+coating+spray |  | Mask connectors and the antenna area.
65 | 7 Chassis & enclosure | Auto-dock contacts (optional) | Spring-loaded brass charging contacts (pair) + dock frame | Later stage: rover returns to a dock and charges on its own | 1 | 0 |  | 0 |  | 800 |  | Optional | Est. | Buy | Amazon.in | https://www.amazon.in/s?k=spring+loaded+charging+contacts+brass
66 | 8 Tools & safety (shared) | Bench power supply | DC bench supply 30 V 5 A with current limit | Safe first power-up of every board (a current limit would have saved the RBT01 on 2026-11-02) | 0 | 1 |  | 0 |  | 4500 |  | Must | Est. | Buy | Amazon.in | https://www.amazon.in/s?k=DC+bench+power+supply+30V+5A | https://robu.in/?s=30V+5A+DC+power+supply&post_type=product
67 | 8 Tools & safety (shared) | ESD workstation | Anti-static mat + wrist strap kit | Board handling without ESD damage (feedback: ESD protection) | 0 | 1 |  | 0 |  | 1200 |  | Must | Est. | Buy | Amazon.in | https://www.amazon.in/s?k=anti+static+mat+wrist+strap+kit | https://robu.in/?s=anti+static+wrist+strap&post_type=product
68 | 8 Tools & safety (shared) | Crimp tool | Ratchet crimper for JST / Dupont terminals | Reliable crimped connectors (no loose wires near the cutter) | 0 | 1 |  | 0 |  | 1500 |  | Should | Est. | Buy | Amazon.in | https://www.amazon.in/s?k=crimping+tool+JST+dupont+ratchet
69 | 8 Tools & safety (shared) | Li-ion safety bag | Fire-resistant battery charging bag | Charge packs safely | 0 | 2 |  | 0 |  | 500 |  | Must | Est. | Buy | Amazon.in | https://www.amazon.in/s?k=lipo+safe+bag+fireproof
70 | 8 Tools & safety (shared) | Digital scale | Kitchen scale 5 kg / 1 g | Weigh real parts and replace the [EST] masses in grasskit_rover.scad | 0 | 1 |  | 0 |  | 400 |  | Optional | Est. | Buy | Amazon.in | https://www.amazon.in/s?k=digital+kitchen+scale+5kg+1g
 |  | TOTAL
 |  | Legend: blue text = editable input (qty, extra, have, unit price). Total qty = qty per rover x rovers (Summary!C6) + extra. To order = total - already have.

Sheet: Design basis
Design basis - why these motors and this battery
Blue = input you can change. Black = formula.
Drive inputs
Rover mass, fully loaded (kg) | 6.5 | Estimate from the parts list; weigh the real rover
Wheel diameter (m) | 0.13 | 130 mm wheel (BOM)
Worst lawn slope (deg) | 15 | Design target
Rolling resistance on grass, Crr | 0.2 | Small wheels on grass, 0.15-0.25
Acceleration (m/s^2) | 0.3
Drivetrain efficiency | 0.75 | Planetary gearbox + tyre
Skid-steer turning factor | 2 | Extra torque while turning on grass (scrub)
Mowing speed (m/s) | 0.3
Motor speed at 12 V (rpm) | 100 | BOM drive motor
Motor rated torque (kg.cm) | 15 | BOM minimum spec
Drive results
Push force needed on the slope (N)
Torque per wheel, straight (N.m)
Torque per wheel while turning (N.m)
Torque per wheel while turning (kg.cm)
Margin: motor rated / needed while turning |  | Above 1.0x = the motor can turn on the slope at its rated (continuous) torque.
Wheel rpm at mowing speed
Top speed at 12 V (m/s)
Power budget while mowing
Cutter (BLDC + 1.6 mm line) | 100 | W (estimate - log real values with the INA226)
Drive, 4 wheels on grass | 25 | W (estimate - log real values with the INA226)
STM32MP257F-DK | 8 | W (estimate - log real values with the INA226)
NUCLEO-N657 + camera | 2.5 | W (estimate - log real values with the INA226)
NUCLEO-G474 + Wi-Fi shield | 1.5 | W (estimate - log real values with the INA226)
LD19 lidar | 1.5 | W (estimate - log real values with the INA226)
ToF sensors, fan, misc | 1.5 | W (estimate - log real values with the INA226)
Total load (W)
Pack nominal voltage (V) | 14.8
Pack capacity (Ah) | 10.0
Usable depth of discharge | 80%
Cutting swath (m) | 0.20
Coverage efficiency (overlap, turns) | 70%
Pack energy (Wh)
Current from the pack while mowing (A)
Runtime per charge (min)
Area mowed per hour, one rover (m^2)
Area mowed per charge, all rovers (m^2)
Cutter line wear signal
Air-drag torque on a spinning line grows with its tip radius^4 at a fixed speed, so a worn line shows up as a clear drop in ESC current at the set rpm (model, not measured).
Line tip radius left (% of new) | Relative air-drag torque
100%
90%
80%
70%
60%
50%

Sheet: Software (free)
Tool | Used for | Link
ROS 2 Jazzy | Robot middleware on the STM32MP2 and the laptop | https://docs.ros.org/en/jazzy/
Gazebo Harmonic | Simulator for the digital twin (lawn world, 2 rovers) | https://gazebosim.org/docs/harmonic/
micro-ROS | ROS 2 nodes on the G474 and N6 MCUs | https://micro.ros.org/
micro_ros_stm32cubemx_utils | micro-ROS for STM32CubeIDE / CubeMX projects | https://github.com/micro-ROS/micro_ros_stm32cubemx_utils
meta-ros | Yocto layer: ROS 2 inside OpenSTLinux on the STM32MP2 | https://github.com/ros/meta-ros
Nav2 | Navigation stack (planner, controller, behaviour trees) | https://docs.nav2.org/
opennav_coverage + Fields2Cover | Stripe (boustrophedon) coverage paths for each zone | https://github.com/open-navigation/opennav_coverage
slam_toolbox | 2D lidar SLAM / lawn map | https://github.com/SteveMacenski/slam_toolbox
robot_localization | EKF fusing wheel odometry + IMU (+ GNSS) | https://github.com/cra-ros-pkg/robot_localization
ldlidar_stl_ros2 | ROS 2 driver for the LD19 lidar | https://github.com/ldrobotSensorTeam/ldlidar_stl_ros2
X-LINUX-RBT1 | ST Linux package for the X-STM32MP-RBT01 | https://www.st.com/en/embedded-software/x-linux-rbt1.html
X-CUBE-ST67W61 | ST67W61 Wi-Fi host driver and examples | https://github.com/STMicroelectronics/x-cube-st67w61
X-CUBE-MCSDK | Motor Control SDK + Workbench for the B-G431B-ESC1 (FOC) | https://www.st.com/en/embedded-software/x-cube-mcsdk.html
STM32 model zoo / ST Edge AI | Vision models for the N6 NPU (detection, segmentation) | https://github.com/STMicroelectronics/stm32ai-modelzoo
STM32CubeIDE | Firmware IDE for all STM32 boards | https://www.st.com/en/development-tools/stm32cubeide.html
OpenSCAD | Parametric chassis model (18_Rover_Chassis_OpenSCAD) | https://openscad.org/
