nottysukku/GrassKit_Rover/18_Rover_Chassis_OpenSCAD/v2_first_parts_list/renders/v2_closed.png

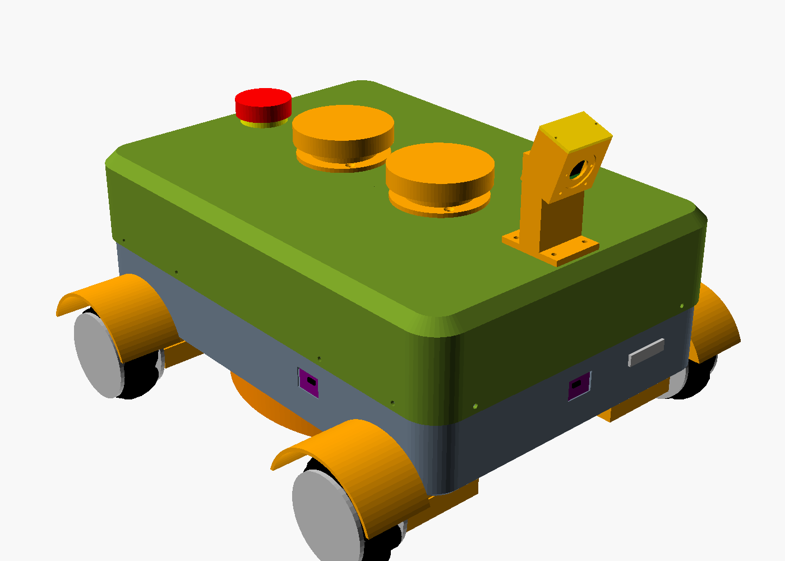
18_Rover_Chassis_OpenSCAD/v2_first_parts_list/renders/v2_closed.png
