nottysukku/GrassKit_Rover/18_Rover_Chassis_OpenSCAD/stl/tub_front_left.stl

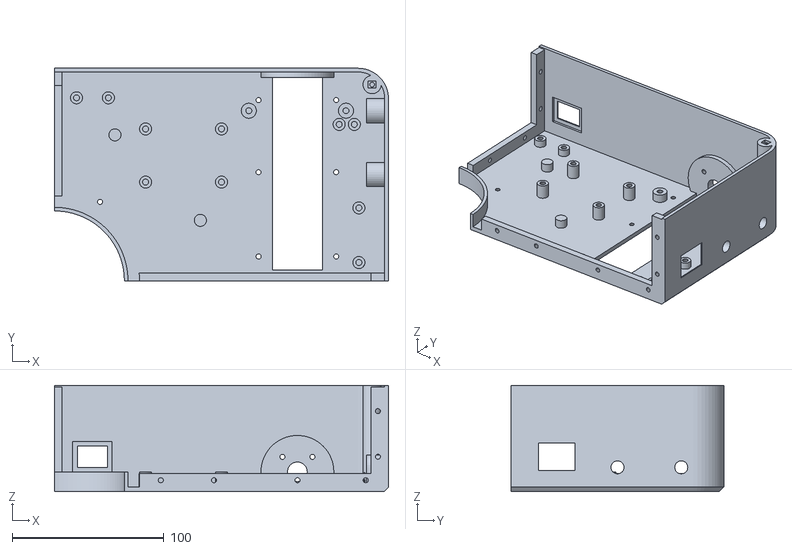
[picture p23: CAD file, 2026-11-05]
18_Rover_Chassis_OpenSCAD/stl/tub_front_left.stl
220.0 x 140.0 x 70.0
