nottysukku/GrassKit_Rover/18_Rover_Chassis_OpenSCAD/v1_3d_print_Chassis/stl/v1_deck.stl

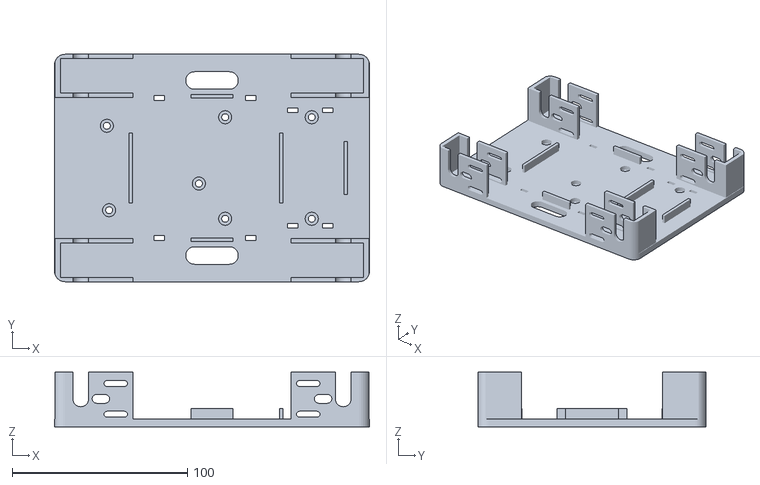
[picture p24: CAD file, 2026-11-05]
18_Rover_Chassis_OpenSCAD/v1_3d_print_Chassis/stl/v1_deck.stl
180.0 x 130.0 x 31.2
