nottysukku/GrassKit_Rover/18_Rover_Chassis_OpenSCAD/v2_first_parts_list/stl/vent_base.stl

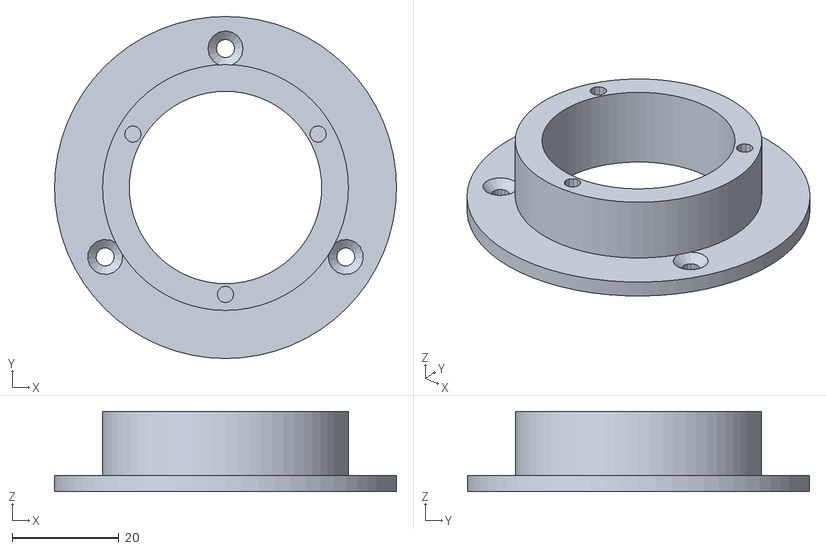
[picture p25: CAD file, 2026-11-05]
18_Rover_Chassis_OpenSCAD/v2_first_parts_list/stl/vent_base.stl
64.0 x 64.0 x 15.0
