nottysukku/GrassKit_Rover/18_Rover_Chassis_OpenSCAD/v1_3d_print_Chassis/stl/v1_spacers.stl

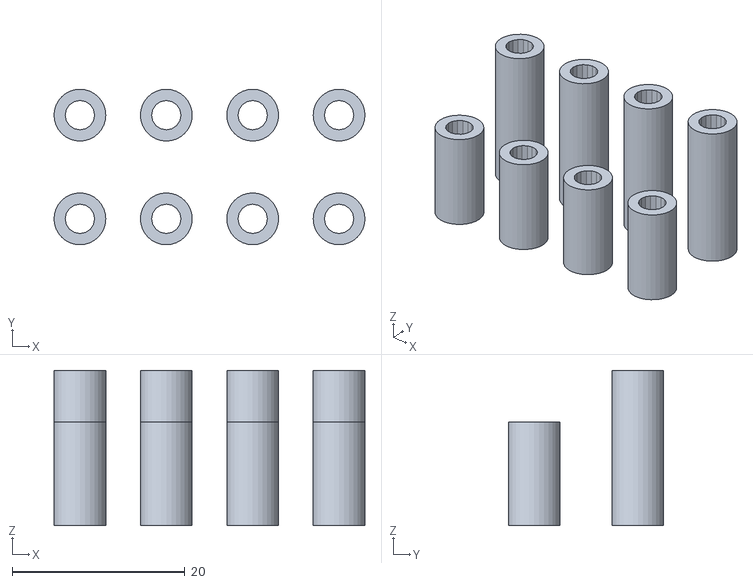
[picture p26: CAD file, 2026-11-05]
18_Rover_Chassis_OpenSCAD/v1_3d_print_Chassis/stl/v1_spacers.stl
36.0 x 18.0 x 18.0
