nottysukku/GrassKit_Rover/18_Rover_Chassis_OpenSCAD/v2_first_parts_list/stl/battery_cradle.stl

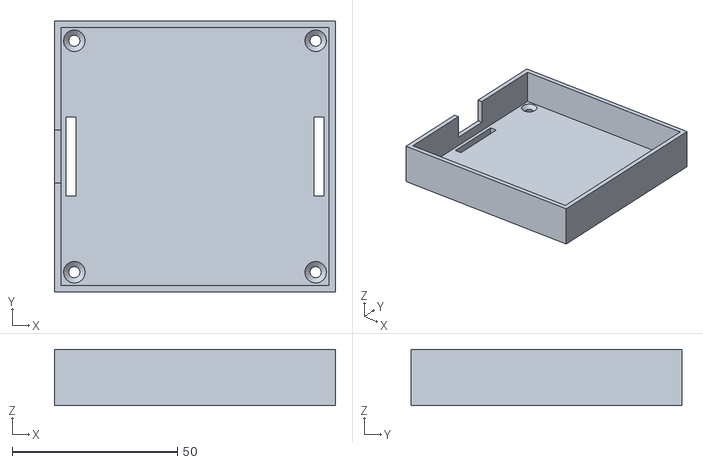
[picture p27: CAD file, 2026-11-05]
18_Rover_Chassis_OpenSCAD/v2_first_parts_list/stl/battery_cradle.stl
85.0 x 82.0 x 17.0
