nottysukku/GrassKit_Rover/18_Rover_Chassis_OpenSCAD/stl/cutter_tower.stl

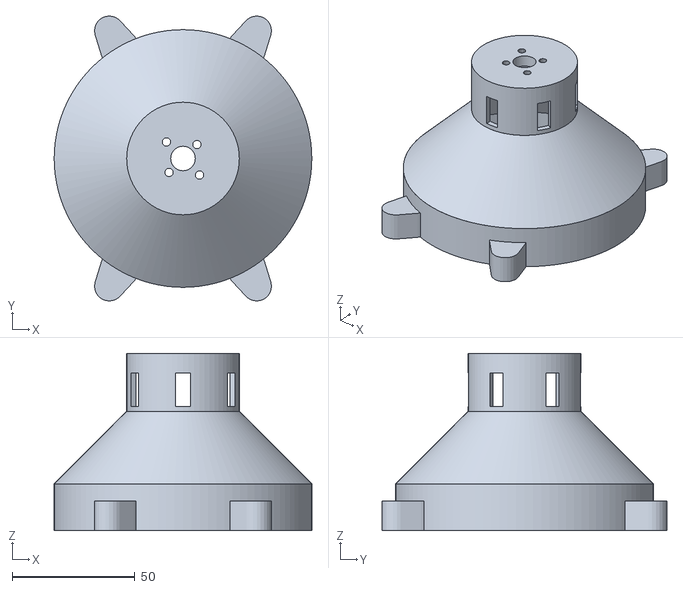
[picture p28: CAD file, 2026-11-05]
18_Rover_Chassis_OpenSCAD/stl/cutter_tower.stl
104.8 x 115.9 x 72.0
