nottysukku/GrassKit_Rover/18_Rover_Chassis_OpenSCAD/v2_first_parts_list/stl/guard_skirt_half.stl

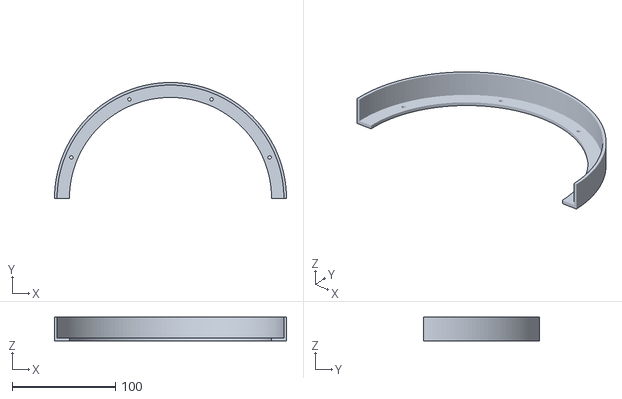
[picture p29: CAD file, 2026-11-05]
18_Rover_Chassis_OpenSCAD/v2_first_parts_list/stl/guard_skirt_half.stl
225.0 x 112.5 x 23.0
