nottysukku/GrassKit_Rover/18_Rover_Chassis_OpenSCAD/stl/deck_front.stl

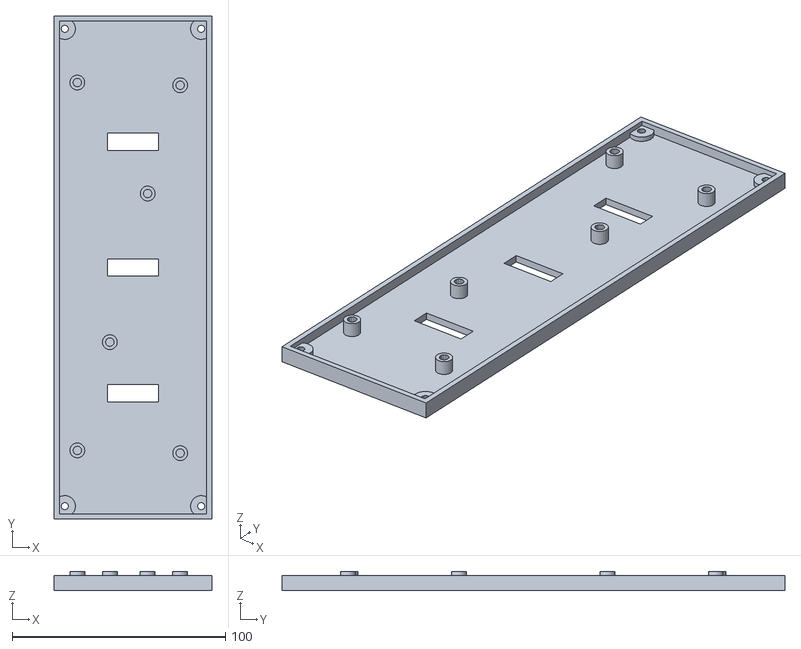
[picture p30: CAD file, 2026-11-05]
18_Rover_Chassis_OpenSCAD/stl/deck_front.stl
74.0 x 236.0 x 9.00
