nottysukku/GrassKit_Rover/18_Rover_Chassis_OpenSCAD/v2_first_parts_list/stl/vent_cap.stl

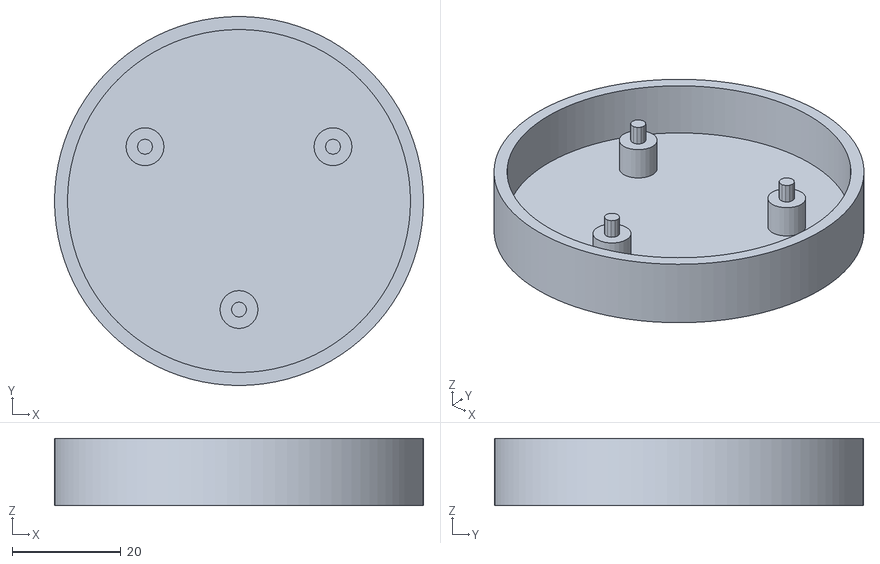
[picture p31: CAD file, 2026-11-05]
18_Rover_Chassis_OpenSCAD/v2_first_parts_list/stl/vent_cap.stl
68.0 x 68.0 x 12.4
