nottysukku/GrassKit_Rover/18_Rover_Chassis_OpenSCAD/stl/lid_front_left.stl

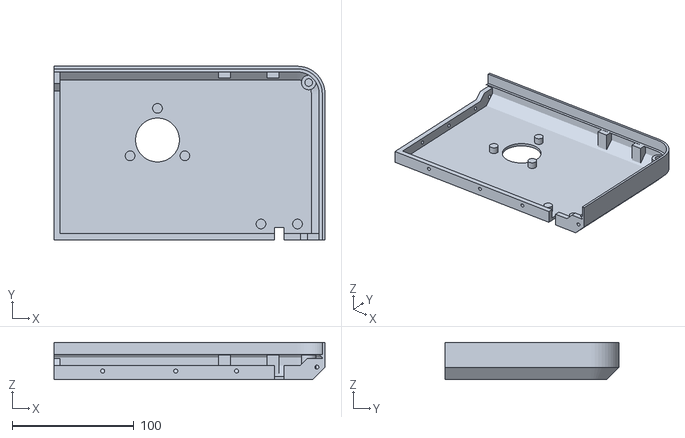
[picture p32: CAD file, 2026-11-05]
18_Rover_Chassis_OpenSCAD/stl/lid_front_left.stl
222.6 x 142.6 x 30.5
