nottysukku/GrassKit_Rover/18_Rover_Chassis_OpenSCAD/v2_first_parts_list/stl/wheel_fender.stl

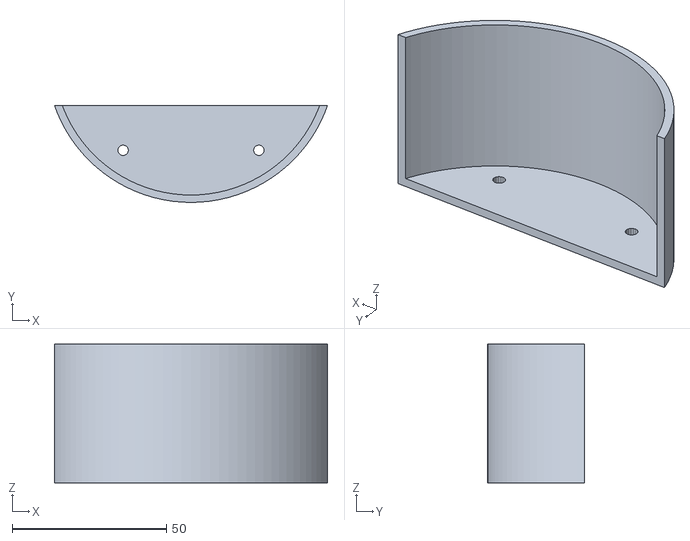
[picture p33: CAD file, 2026-11-05]
18_Rover_Chassis_OpenSCAD/v2_first_parts_list/stl/wheel_fender.stl
88.5 x 31.4 x 45.0
