nottysukku/GrassKit_Rover/18_Rover_Chassis_OpenSCAD/stl/motor_tray.stl

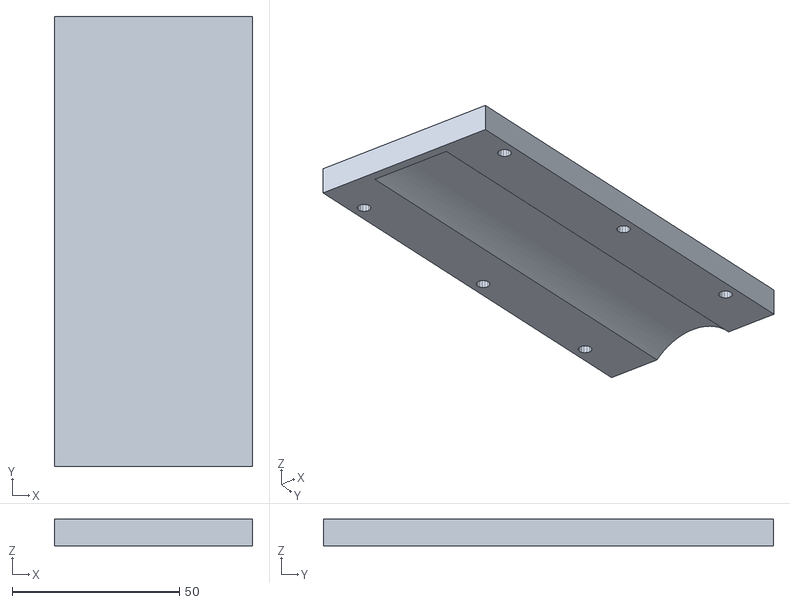
[picture p34: CAD file, 2026-11-05]
18_Rover_Chassis_OpenSCAD/stl/motor_tray.stl
59.1 x 134.5 x 8.00
