nottysukku/GrassKit_Rover/18_Rover_Chassis_OpenSCAD/v2_first_parts_list/stl/cutter_tower.stl

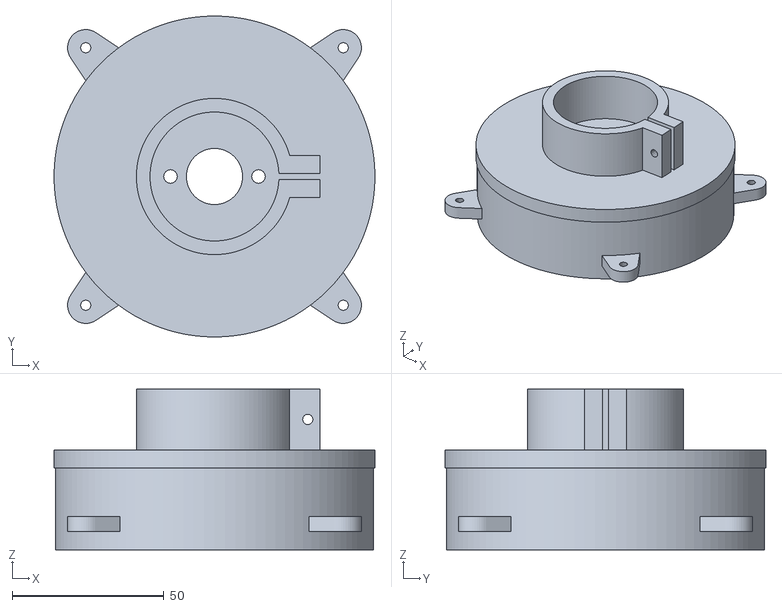
[picture p36: CAD file, 2026-11-05]
18_Rover_Chassis_OpenSCAD/v2_first_parts_list/stl/cutter_tower.stl
105.8 x 105.8 x 53.0
