nottysukku/GrassKit_Rover/18_Rover_Chassis_OpenSCAD/stl/motor_clamp.stl

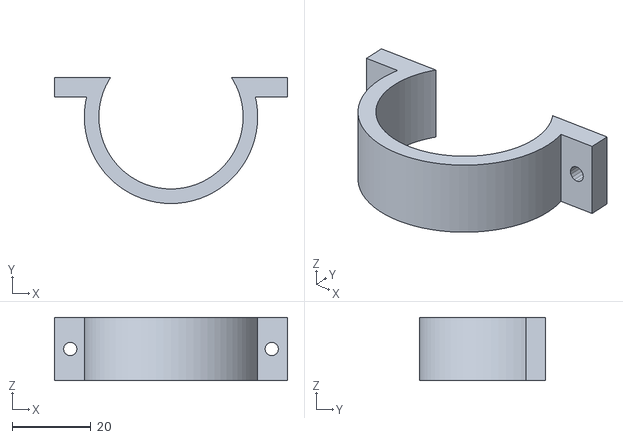
[picture p37: CAD file, 2026-11-05]
18_Rover_Chassis_OpenSCAD/stl/motor_clamp.stl
59.1 x 32.0 x 16.0
