nottysukku/GrassKit_Rover/18_Rover_Chassis_OpenSCAD/v2_first_parts_list/stl/camera_pod_cover.stl

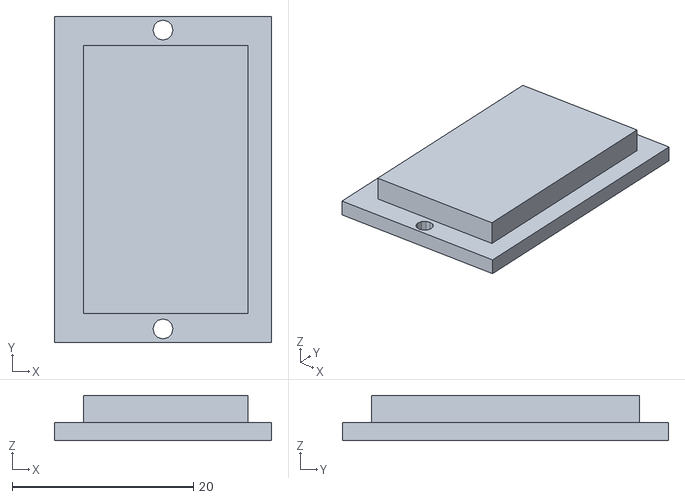
[picture p39: CAD file, 2026-11-05]
18_Rover_Chassis_OpenSCAD/v2_first_parts_list/stl/camera_pod_cover.stl
24.0 x 36.0 x 5.00
