nottysukku/GrassKit_Rover/18_Rover_Chassis_OpenSCAD/stl/bumper_switch_bracket.stl

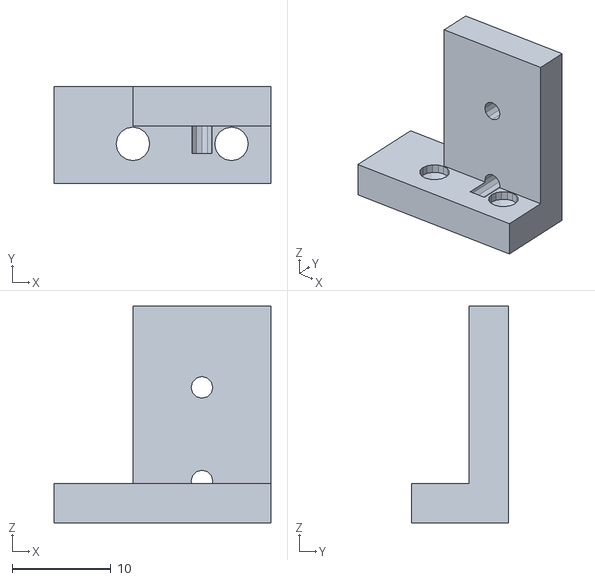
[picture p40: CAD file, 2026-11-05]
18_Rover_Chassis_OpenSCAD/stl/bumper_switch_bracket.stl
22.0 x 9.80 x 22.0
