nottysukku/GrassKit_Rover/18_Rover_Chassis_OpenSCAD/stl/bumper_half.stl

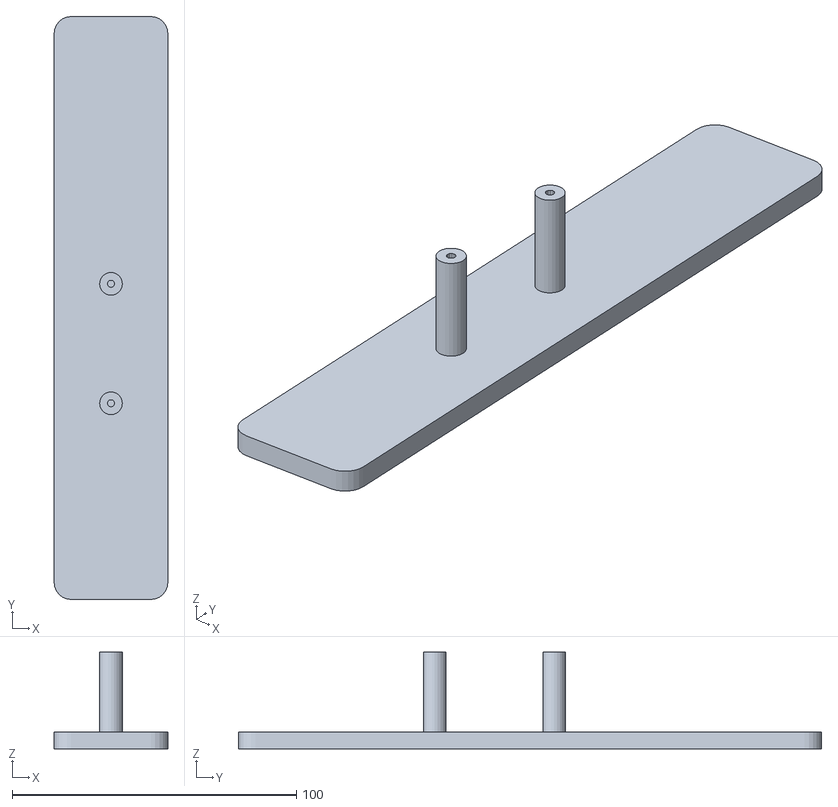
[picture p42: CAD file, 2026-11-05]
18_Rover_Chassis_OpenSCAD/stl/bumper_half.stl
40.0 x 205.0 x 34.0
