nottysukku/GrassKit_Rover/18_Rover_Chassis_OpenSCAD/v2_first_parts_list/stl/tub_rear_half.stl

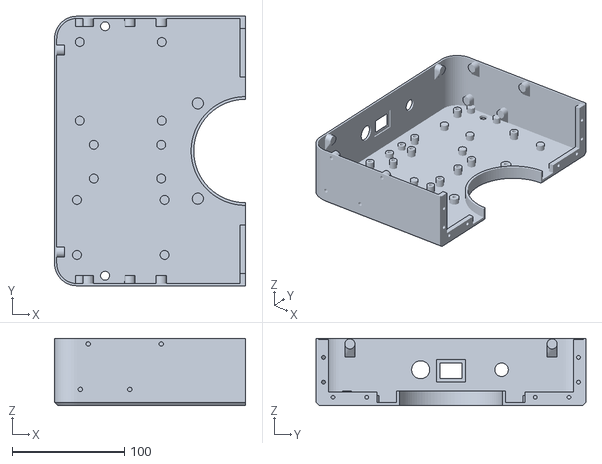
[picture p43: CAD file, 2026-11-05]
18_Rover_Chassis_OpenSCAD/v2_first_parts_list/stl/tub_rear_half.stl
170.0 x 240.0 x 60.0
