nottysukku/GrassKit_Rover/18_Rover_Chassis_OpenSCAD/stl/esc_mount.stl

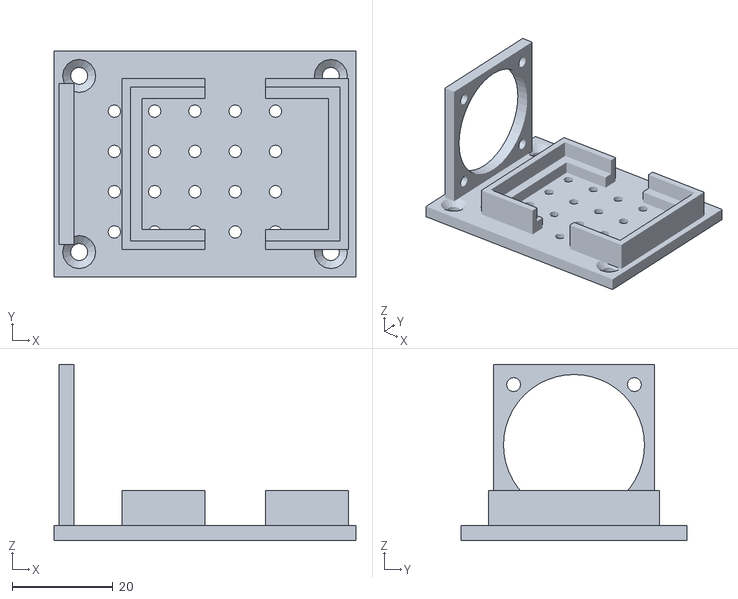
[picture p45: CAD file, 2026-11-05]
18_Rover_Chassis_OpenSCAD/stl/esc_mount.stl
60.0 x 45.0 x 35.0
