nottysukku/GrassKit_Rover/18_Rover_Chassis_OpenSCAD/v2_first_parts_list/stl/lid_rear_half.stl

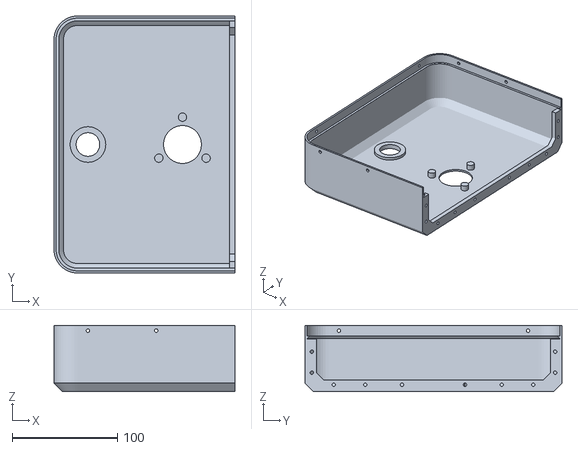
[picture p46: CAD file, 2026-11-05]
18_Rover_Chassis_OpenSCAD/v2_first_parts_list/stl/lid_rear_half.stl
172.3 x 244.6 x 63.0
