nottysukku/GrassKit_Rover/18_Rover_Chassis_OpenSCAD/stl/wheel_fender.stl

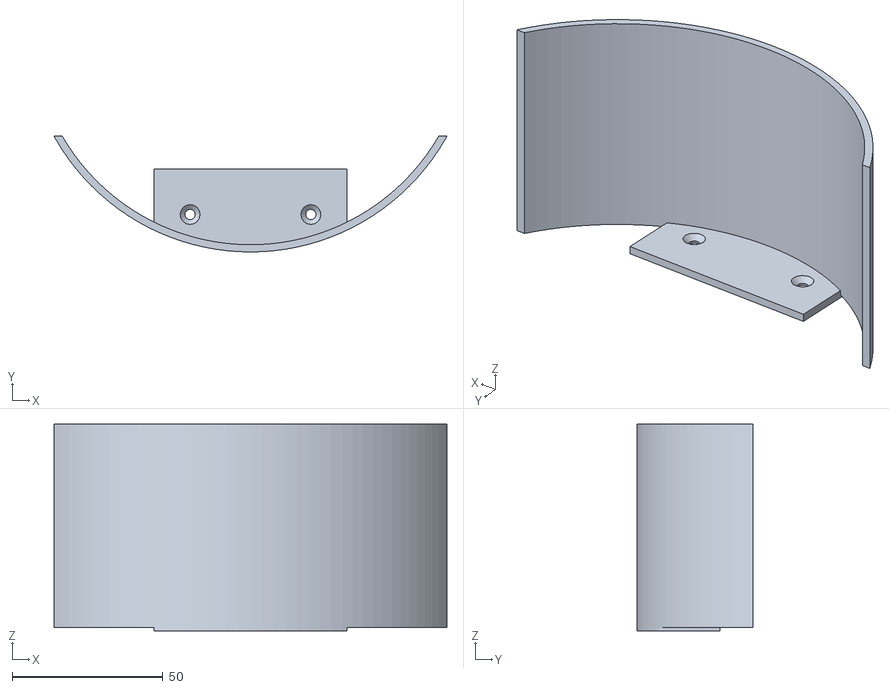
[picture p47: CAD file, 2026-11-05]
18_Rover_Chassis_OpenSCAD/stl/wheel_fender.stl
130.2 x 38.4 x 68.4
