nottysukku/GrassKit_Rover/18_Rover_Chassis_OpenSCAD/stl/lid_front_right.stl

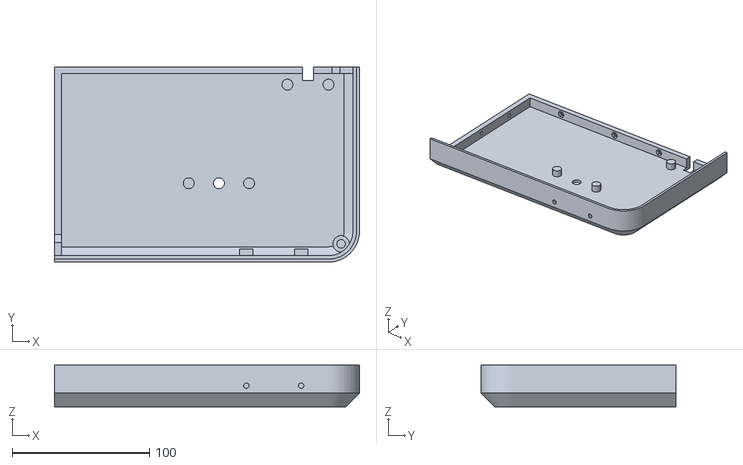
[picture p49: CAD file, 2026-11-05]
18_Rover_Chassis_OpenSCAD/stl/lid_front_right.stl
222.6 x 142.6 x 30.5
