nottysukku/GrassKit_Rover/18_Rover_Chassis_OpenSCAD/stl/battery_cradle.stl

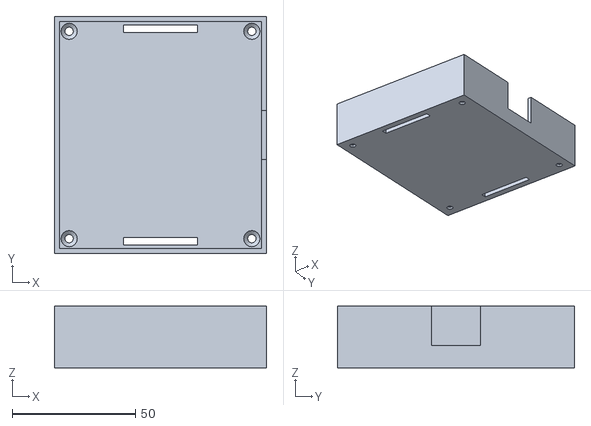
[picture p50: CAD file, 2026-11-05]
18_Rover_Chassis_OpenSCAD/stl/battery_cradle.stl
86.0 x 96.0 x 25.0
