nottysukku/GrassKit_Rover/18_Rover_Chassis_OpenSCAD/stl/power_plate.stl

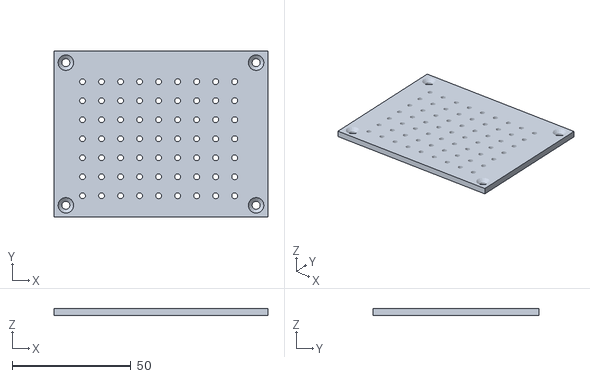
[picture p51: CAD file, 2026-11-05]
18_Rover_Chassis_OpenSCAD/stl/power_plate.stl
90.0 x 70.0 x 3.00
