nottysukku/GrassKit_Rover/18_Rover_Chassis_OpenSCAD/stl/guard_skirt_half.stl

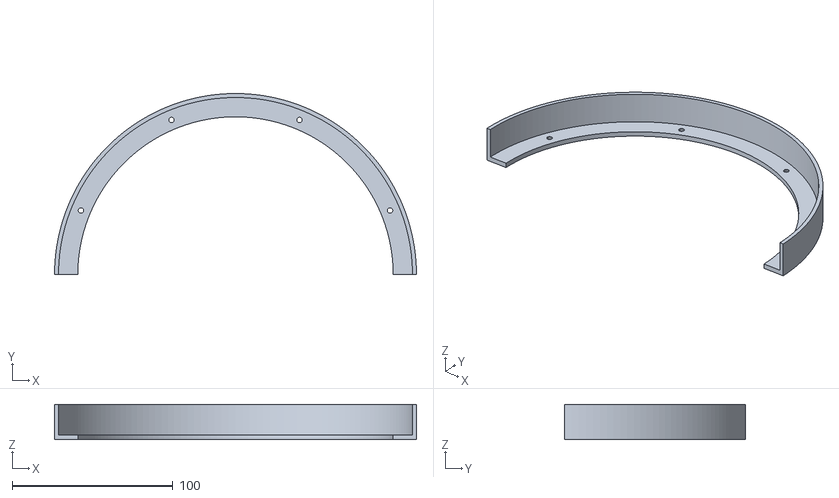
[picture p52: CAD file, 2026-11-05]
18_Rover_Chassis_OpenSCAD/stl/guard_skirt_half.stl
225.0 x 112.5 x 22.0
