nottysukku/GrassKit_Rover/18_Rover_Chassis_OpenSCAD/stl/camera_pod.stl

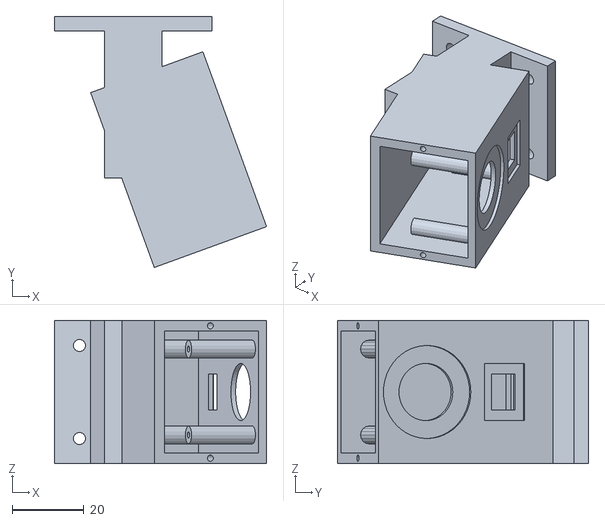
[picture p54: CAD file, 2026-11-05]
18_Rover_Chassis_OpenSCAD/stl/camera_pod.stl
59.3 x 70.1 x 40.0
