nottysukku/GrassKit_Rover/18_Rover_Chassis_OpenSCAD/stl/lidar_mast.stl

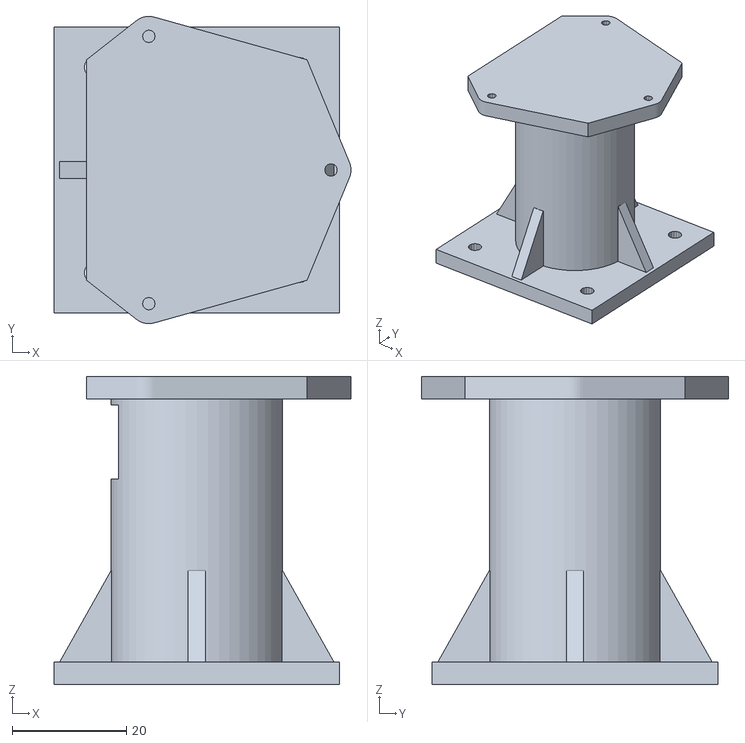
[picture p55: CAD file, 2026-11-05]
18_Rover_Chassis_OpenSCAD/stl/lidar_mast.stl
52.0 x 53.8 x 54.0
