nottysukku/GrassKit_Rover/18_Rover_Chassis_OpenSCAD/stl/tof_holder_l9.stl

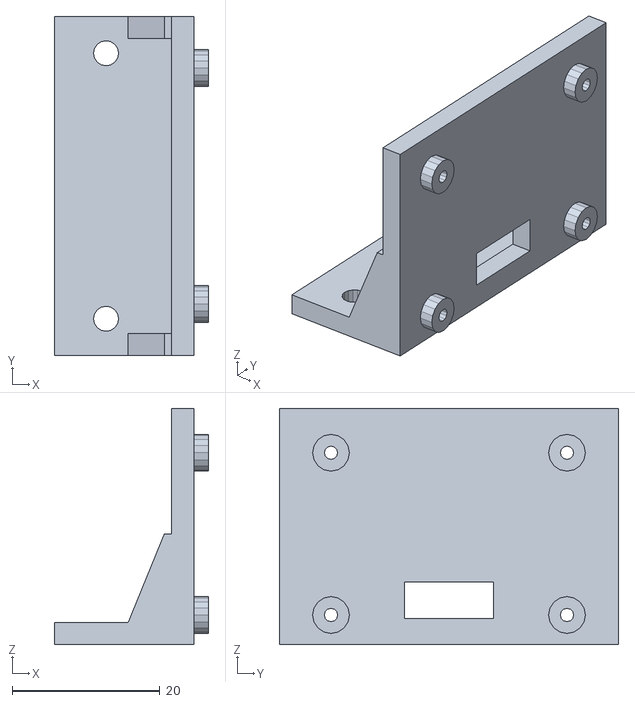
[picture p56: CAD file, 2026-11-05]
18_Rover_Chassis_OpenSCAD/stl/tof_holder_l9.stl
20.9 x 46.0 x 32.0
