nottysukku/GrassKit_Rover/18_Rover_Chassis_OpenSCAD/stl/deck_rear.stl

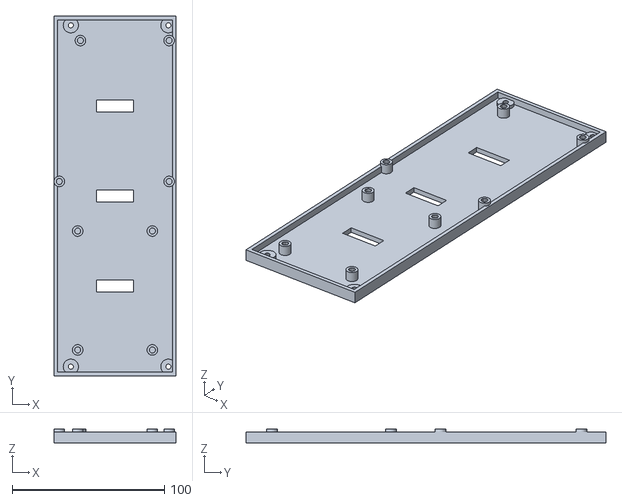
[picture p57: CAD file, 2026-11-05]
18_Rover_Chassis_OpenSCAD/stl/deck_rear.stl
80.0 x 236.0 x 9.00
