nottysukku/GrassKit_Rover/18_Rover_Chassis_OpenSCAD/stl/camera_pod_cover.stl

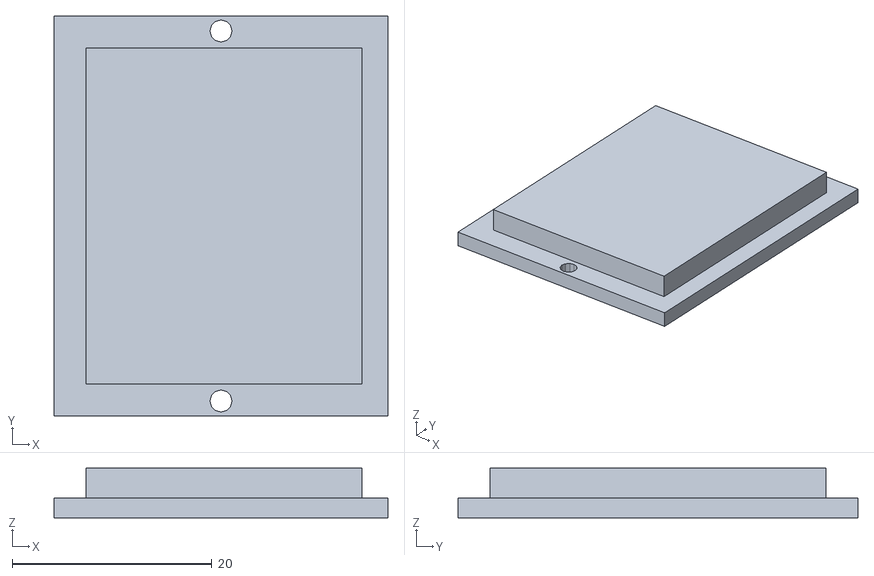
[picture p58: CAD file, 2026-11-05]
18_Rover_Chassis_OpenSCAD/stl/camera_pod_cover.stl
33.4 x 40.0 x 5.00
