nottysukku/GrassKit_Rover/18_Rover_Chassis_OpenSCAD/stl/tof_holder_l8.stl

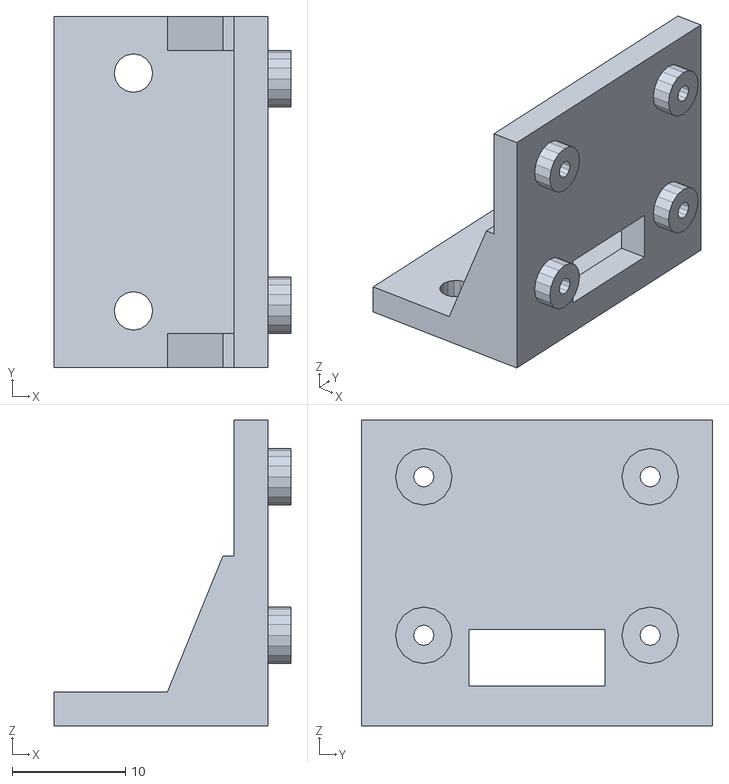
[picture p59: CAD file, 2026-11-05]
18_Rover_Chassis_OpenSCAD/stl/tof_holder_l8.stl
20.9 x 31.0 x 27.0
