nottysukku/GrassKit_Rover/(list of files, cad)

Other CAD files:
18_Rover_Chassis_OpenSCAD/stl/tub_rear_right.stl
18_Rover_Chassis_OpenSCAD/stl/tub_rear_left.stl
18_Rover_Chassis_OpenSCAD/stl/vent_cap.stl
18_Rover_Chassis_OpenSCAD/stl/tub_front_right.stl
18_Rover_Chassis_OpenSCAD/v2_first_parts_list/stl/lid_front_half.stl
18_Rover_Chassis_OpenSCAD/v2_first_parts_list/stl/tub_front_half.stl
18_Rover_Chassis_OpenSCAD/stl/lid_rear_right.stl
18_Rover_Chassis_OpenSCAD/stl/vent_base.stl
18_Rover_Chassis_OpenSCAD/v2_first_parts_list/rover_bought_parts.scad
18_Rover_Chassis_OpenSCAD/v2_first_parts_list/rover_printed_parts.scad
