nottysukku/GrassKit_Rover/17_Rover_MotorDriver_WiFi_ST67W61/docs/wiring_schematic.png

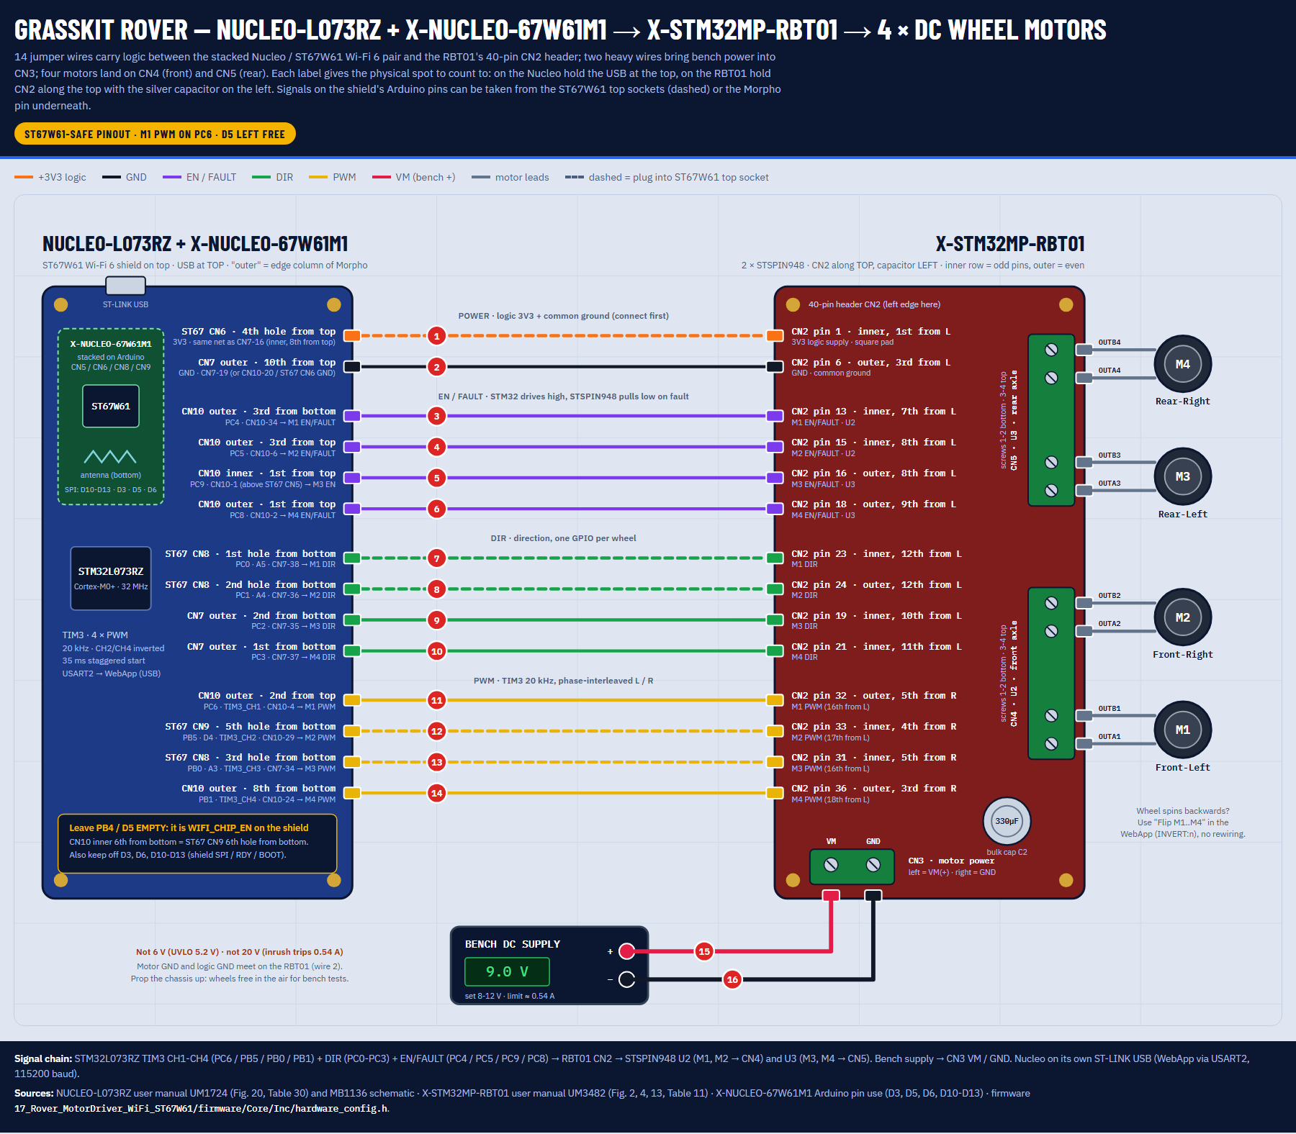
17_Rover_MotorDriver_WiFi_ST67W61/docs/wiring_schematic.png
