nottysukku/GrassKit_Rover/18_Rover_Chassis_OpenSCAD/v1_3d_print_Chassis/renders/deck_as_printed.png

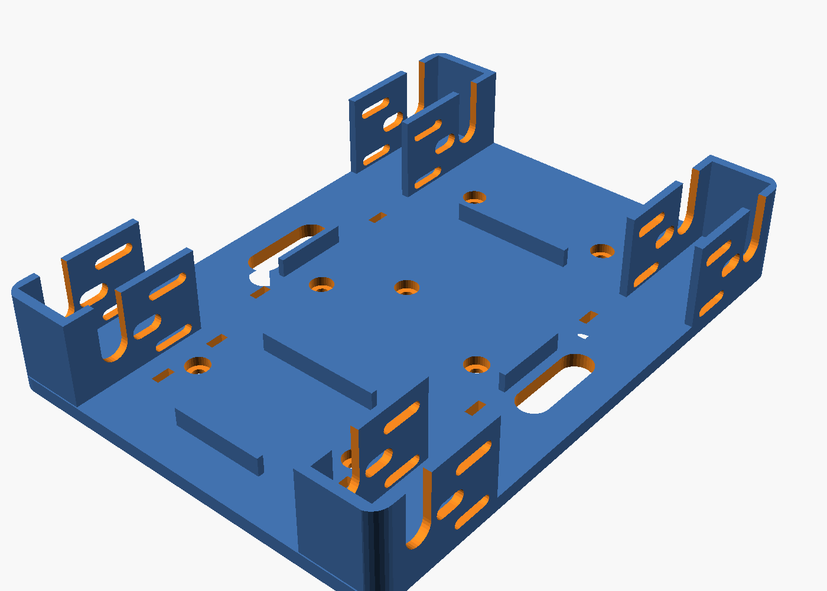
18_Rover_Chassis_OpenSCAD/v1_3d_print_Chassis/renders/deck_as_printed.png
