nottysukku/GrassKit_Rover/16_RaceCar_MotorDriver_Bluetooth_Audio/firmware/Core/Src/main.c

/**
  ******************************************************************************
  * @file           : main.c
  * @brief          : Main program body for STM32L073RZ Race Car Demonstrator.
  ******************************************************************************
  * Target Hardware:
  *   - MCU: STM32L073RZ (NUCLEO-L073RZ)
  *   - Motor Driver: ST X-STM32MP-RBT01 (Dual STSPIN948, 4 DC Brushed Motors)
  *   - Bluetooth: ST X-NUCLEO-IDB05A2 / External UART Module
  *   - Chassis: 4-Wheel Mecanum Drive
  ******************************************************************************
  */

#include "main.h"
#include "app.h"

static void SystemClock_Config(void);

int main(void)
{
    /* Reset of all peripherals, Initializes the Flash interface and the Systick. */
    HAL_Init();

    /* Configure the system clock to 32 MHz using HSI16 and PLL */
    SystemClock_Config();

    /* Initialize Application Modules (Motors, Engine Model, Bluetooth, Safety) */
    App_Init();

    /* Infinite loop */
    while (1)
    {
        App_Run();
    }
}

/**
  * @brief System Clock Configuration (32 MHz via HSI16 + PLL)
  */
static void SystemClock_Config(void)
{
    RCC_OscInitTypeDef RCC_OscInitStruct = {0};
    RCC_ClkInitTypeDef RCC_ClkInitStruct = {0};
    RCC_PeriphCLKInitTypeDef PeriphClkInit = {0};

    /* Configure the main internal regulator output voltage */
    __HAL_PWR_VOLTAGESCALING_CONFIG(PWR_REGULATOR_VOLTAGE_SCALE1);

    /* Initializes the RCC Oscillators: HSI16 with PLL to achieve 32 MHz */
    RCC_OscInitStruct.OscillatorType = RCC_OSCILLATORTYPE_HSI;
    RCC_OscInitStruct.HSIState = RCC_HSI_ON;
    RCC_OscInitStruct.HSICalibrationValue = RCC_HSICALIBRATION_DEFAULT;
    RCC_OscInitStruct.PLL.PLLState = RCC_PLL_ON;
    RCC_OscInitStruct.PLL.PLLSource = RCC_PLLSOURCE_HSI;
    RCC_OscInitStruct.PLL.PLLMUL = RCC_PLLMUL_4;
    RCC_OscInitStruct.PLL.PLLDIV = RCC_PLLDIV_2;
    if (HAL_RCC_OscConfig(&RCC_OscInitStruct) != HAL_OK)
    {
        Error_Handler();
    }

    /* Initializes the CPU, AHB and APB buses clocks */
    RCC_ClkInitStruct.ClockType = RCC_CLOCKTYPE_HCLK | RCC_CLOCKTYPE_SYSCLK
                                | RCC_CLOCKTYPE_PCLK1 | RCC_CLOCKTYPE_PCLK2;
    RCC_ClkInitStruct.SYSCLKSource = RCC_SYSCLKSOURCE_PLLCLK;
    RCC_ClkInitStruct.AHBCLKDivider = RCC_SYSCLK_DIV1;
    RCC_ClkInitStruct.APB1CLKDivider = RCC_HCLK_DIV1;
    RCC_ClkInitStruct.APB2CLKDivider = RCC_HCLK_DIV1;

    if (HAL_RCC_ClockConfig(&RCC_ClkInitStruct, FLASH_LATENCY_1) != HAL_OK)
    {
        Error_Handler();
    }

    /* Configure USART1 & USART2 clock sources to SYSCLK (32 MHz) */
    PeriphClkInit.PeriphClockSelection = RCC_PERIPHCLK_USART1 | RCC_PERIPHCLK_USART2;
    PeriphClkInit.Usart1ClockSelection = RCC_USART1CLKSOURCE_SYSCLK;
    PeriphClkInit.Usart2ClockSelection = RCC_USART2CLKSOURCE_SYSCLK;
    if (HAL_RCCEx_PeriphCLKConfig(&PeriphClkInit) != HAL_OK)
    {
        Error_Handler();
    }
}

void Error_Handler(void)
{
    __disable_irq();
    while (1)
    {
    }
}
