nottysukku/GrassKit_Rover/16_RaceCar_MotorDriver_Bluetooth_Audio/firmware/Core/Src/motor_control.c

/**
  ******************************************************************************
  * @file           : motor_control.c
  * @brief          : Motor driver implementation for STSPIN948 on X-STM32MP-RBT01.
  *                   Handles 4 brushed DC motors and 4-wheel Mecanum kinematics.
  ******************************************************************************
  */

#include "motor_control.h"
#include <math.h>
#include <string.h>

static MotorControl_t g_motor_ctrl;
static TIM_HandleTypeDef htim3_motors;

static const uint16_t s_motor_en_pins[4] = {
    MOTOR1_EN_PIN, MOTOR2_EN_PIN, MOTOR3_EN_PIN, MOTOR4_EN_PIN
};

/* Private Helper Declarations */
static void Motor_Hardware_Init_GPIO(void);
static void Motor_Hardware_Init_TIM3(void);
static void Motor_SetBridgesEnabled(bool enable);
static bool Motor_CheckDriverFault(uint32_t delta_ms);
static void Motor_ApplyPWMAndDirection(uint8_t id, float speed);
static float Motor_Clamp(float val, float min_val, float max_val);

void Motor_Init(void)
{
    memset(&g_motor_ctrl, 0, sizeof(g_motor_ctrl));
    g_motor_ctrl.state = MOTOR_STATE_DISABLED;
    g_motor_ctrl.drive_mode = DRIVE_MODE_MECANUM_OMNI;
    /* Right-side motors (M2 FR, M4 RR) are mounted mirrored on the chassis */
    g_motor_ctrl.motors[1].invert_dir = true;
    g_motor_ctrl.motors[3].invert_dir = true;

    /* Initialize low-level peripherals */
    Motor_Hardware_Init_GPIO();
    Motor_Hardware_Init_TIM3();

    /* Ensure all four bridges are held disabled (outputs high-Z) initially */
    Motor_SetBridgesEnabled(false);

    g_motor_ctrl.state = MOTOR_STATE_IDLE;
}

static void Motor_Hardware_Init_GPIO(void)
{
    GPIO_InitTypeDef GPIO_InitStruct = {0};

    /* Enable GPIO Clocks */
    __HAL_RCC_GPIOB_CLK_ENABLE();
    __HAL_RCC_GPIOC_CLK_ENABLE();

    /* Bridge EN/nFAULT Pins: PC4, PC5, PC6, PC8 Output Open-Drain.
     * The RBT01 pulls each line to 3V3 (bridge enabled by default), so latch
     * them low before switching to output mode. No internal pull: the on-board
     * 39k / 10nF network sets the enable level and overcurrent retry time. */
    HAL_GPIO_WritePin(MOTOR_EN_GPIO_PORT, MOTOR_EN_ALL_PINS, GPIO_PIN_RESET);
    GPIO_InitStruct.Pin = MOTOR_EN_ALL_PINS;
    GPIO_InitStruct.Mode = GPIO_MODE_OUTPUT_OD;
    GPIO_InitStruct.Pull = GPIO_NOPULL;
    GPIO_InitStruct.Speed = GPIO_SPEED_FREQ_LOW;
    HAL_GPIO_Init(MOTOR_EN_GPIO_PORT, &GPIO_InitStruct);

    /* Direction (PHx) Pins: PC0, PC1, PC2, PC3 Output Push-Pull with pull-down */
    GPIO_InitStruct.Pin = MOTOR1_DIR_PIN | MOTOR2_DIR_PIN | MOTOR3_DIR_PIN | MOTOR4_DIR_PIN;
    GPIO_InitStruct.Mode = GPIO_MODE_OUTPUT_PP;
    GPIO_InitStruct.Pull = GPIO_PULLDOWN;
    GPIO_InitStruct.Speed = GPIO_SPEED_FREQ_LOW;
    HAL_GPIO_Init(GPIOC, &GPIO_InitStruct);

    /* All Direction outputs low initially */
    HAL_GPIO_WritePin(GPIOC, MOTOR1_DIR_PIN | MOTOR2_DIR_PIN | MOTOR3_DIR_PIN | MOTOR4_DIR_PIN, GPIO_PIN_RESET);
}

static void Motor_Hardware_Init_TIM3(void)
{
    TIM_OC_InitTypeDef sConfigOC = {0};
    GPIO_InitTypeDef GPIO_InitStruct = {0};

    MOTOR_PWM_TIMER_CLK_ENABLE();

    /* Configure PC6 (Motor 1 / CH1) as TIM3 Alternate Function AF2 with pull-down */
    GPIO_InitStruct.Pin = MOTOR1_PWM_PIN;
    GPIO_InitStruct.Mode = GPIO_MODE_AF_PP;
    GPIO_InitStruct.Pull = GPIO_PULLDOWN;
    GPIO_InitStruct.Speed = GPIO_SPEED_FREQ_HIGH;
    GPIO_InitStruct.Alternate = GPIO_AF2_TIM3;
    HAL_GPIO_Init(MOTOR1_PWM_GPIO_PORT, &GPIO_InitStruct);

    /* Configure PB0 (CH3), PB1 (CH4) as TIM3 Alternate Function AF2 with pull-down */
    GPIO_InitStruct.Pin = MOTOR3_PWM_PIN | MOTOR4_PWM_PIN;
    GPIO_InitStruct.Mode = GPIO_MODE_AF_PP;
    GPIO_InitStruct.Pull = GPIO_PULLDOWN;
    GPIO_InitStruct.Speed = GPIO_SPEED_FREQ_HIGH;
    GPIO_InitStruct.Alternate = GPIO_AF2_TIM3;
    HAL_GPIO_Init(GPIOB, &GPIO_InitStruct);

    /* Configure PB5 (CH2) as TIM3 Alternate Function AF4 (STM32L0 TIM3_CH2 is AF4 on PB5,
     * and only once the TIM3_OR remap below is set) */
    GPIO_InitStruct.Pin = MOTOR2_PWM_PIN;
    GPIO_InitStruct.Alternate = GPIO_AF4_TIM3;
    HAL_GPIO_Init(GPIOB, &GPIO_InitStruct);

    /* Timer Base Configuration: 32 MHz / 1 (Prescaler 0) = 32 MHz tick.
     * Period = 1600 - 1 -> Frequency = 32,000,000 / 1600 = 20,000 Hz (20 kHz) */
    htim3_motors.Instance = MOTOR_PWM_TIMER;
    htim3_motors.Init.Prescaler = 0;
    htim3_motors.Init.CounterMode = TIM_COUNTERMODE_UP;
    htim3_motors.Init.Period = MOTOR_PWM_PERIOD_TICKS - 1;
    htim3_motors.Init.ClockDivision = TIM_CLOCKDIVISION_DIV1;
    htim3_motors.Init.AutoReloadPreload = TIM_AUTORELOAD_PRELOAD_ENABLE;
    HAL_TIM_PWM_Init(&htim3_motors);

    /* PB5 (AF4) carries TIM22_CH2 by default: route TIM3_CH2 to it instead,
     * otherwise Motor 2 never gets a PWM signal */
    HAL_TIMEx_RemapConfig(&htim3_motors, TIM3_TI2_GPIOB5_AF4);

    /* Output Compare Configuration:
     * Phase-interleave Bridge A (M1/CH1, M3/CH3 -> PWM Mode 1, active at start of period)
     * against Bridge B (M2/CH2, M4/CH4 -> PWM Mode 2, active at end of period) */
    sConfigOC.OCMode = TIM_OCMODE_PWM1;
    sConfigOC.Pulse = 0;
    sConfigOC.OCPolarity = TIM_OCPOLARITY_HIGH;
    sConfigOC.OCFastMode = TIM_OCFAST_DISABLE;

    HAL_TIM_PWM_ConfigChannel(&htim3_motors, &sConfigOC, TIM_CHANNEL_1);
    HAL_TIM_PWM_ConfigChannel(&htim3_motors, &sConfigOC, TIM_CHANNEL_3);

    sConfigOC.OCMode = TIM_OCMODE_PWM2;
    sConfigOC.Pulse = MOTOR_PWM_PERIOD_TICKS;
    HAL_TIM_PWM_ConfigChannel(&htim3_motors, &sConfigOC, TIM_CHANNEL_2);
    HAL_TIM_PWM_ConfigChannel(&htim3_motors, &sConfigOC, TIM_CHANNEL_4);

    /* Start PWM channels */
    HAL_TIM_PWM_Start(&htim3_motors, TIM_CHANNEL_1);
    HAL_TIM_PWM_Start(&htim3_motors, TIM_CHANNEL_2);
    HAL_TIM_PWM_Start(&htim3_motors, TIM_CHANNEL_3);
    HAL_TIM_PWM_Start(&htim3_motors, TIM_CHANNEL_4);
}

/**
 * @brief  Enable or disable all four full-bridges through their EN/nFAULT lines.
 *         Releasing a line lets the RBT01 pull-up enable the bridge; driving it
 *         low puts the bridge outputs in high-Z.
 */
static void Motor_SetBridgesEnabled(bool enable)
{
    if (enable && !g_motor_ctrl.bridges_enabled) {
        g_motor_ctrl.fault_blanking_ms = MOTOR_FAULT_BLANKING_MS;
        memset(g_motor_ctrl.fault_samples, 0, sizeof(g_motor_ctrl.fault_samples));
    }

    HAL_GPIO_WritePin(MOTOR_EN_GPIO_PORT, MOTOR_EN_ALL_PINS, enable ? GPIO_PIN_SET : GPIO_PIN_RESET);
    g_motor_ctrl.bridges_enabled = enable;
}

/**
 * @brief  Sample the EN/nFAULT lines of the enabled bridges (called every 1 ms)
 * @retval true if a driver is holding its line low (UVLO, overcurrent or
 *         thermal shutdown); the affected motors are recorded in fault_mask
 */
static bool Motor_CheckDriverFault(uint32_t delta_ms)
{
    if (!g_motor_ctrl.bridges_enabled) {
        return false; /* Lines are held low by the MCU itself */
    }

    if (g_motor_ctrl.fault_blanking_ms > delta_ms) {
        g_motor_ctrl.fault_blanking_ms -= delta_ms;
        return false;
    }
    g_motor_ctrl.fault_blanking_ms = 0;

    for (int i = 0; i < 4; i++) {
        if (HAL_GPIO_ReadPin(MOTOR_EN_GPIO_PORT, s_motor_en_pins[i]) == GPIO_PIN_RESET) {
            if (++g_motor_ctrl.fault_samples[i] >= MOTOR_FAULT_DEBOUNCE_SAMPLES) {
                g_motor_ctrl.fault_mask |= (uint8_t)(1U << i);
            }
        } else if (g_motor_ctrl.fault_samples[i] > 0) {
            g_motor_ctrl.fault_samples[i]--;
        }
    }

    return g_motor_ctrl.fault_mask != 0;
}

void Motor_Start(void)
{
    if (g_motor_ctrl.estop_active) {
        return; /* Require explicit reset if e-stop was tripped */
    }

    Motor_SetBridgesEnabled(true);
    g_motor_ctrl.state = MOTOR_STATE_RUNNING;
}

void Motor_Stop(void)
{
    /* Set all target speeds to zero gracefully */
    for (int i = 0; i < 4; i++) {
        g_motor_ctrl.motors[i].target_speed = 0.0f;
    }
    g_motor_ctrl.overall_throttle = 0.0f;
    g_motor_ctrl.overall_steer = 0.0f;
    g_motor_ctrl.overall_strafe = 0.0f;
    g_motor_ctrl.state = MOTOR_STATE_IDLE;
}

void Motor_Brake(void)
{
    /* Active braking: Immediately zero PWM duty but keep bridge enabled */
    for (int i = 0; i < 4; i++) {
        g_motor_ctrl.motors[i].target_speed = 0.0f;
        g_motor_ctrl.motors[i].current_speed = 0.0f;
        Motor_ApplyPWMAndDirection(i, 0.0f);
    }
    g_motor_ctrl.overall_throttle = 0.0f;
    g_motor_ctrl.state = MOTOR_STATE_BRAKING;
}

void Motor_EmergencyStop(void)
{
    /* Instant hardware shutdown: Disable driver & set duty to 0 */
    Motor_SetBridgesEnabled(false);

    __HAL_TIM_SET_COMPARE(&htim3_motors, TIM_CHANNEL_1, 0);
    __HAL_TIM_SET_COMPARE(&htim3_motors, TIM_CHANNEL_2, MOTOR_PWM_PERIOD_TICKS);
    __HAL_TIM_SET_COMPARE(&htim3_motors, TIM_CHANNEL_3, 0);
    __HAL_TIM_SET_COMPARE(&htim3_motors, TIM_CHANNEL_4, MOTOR_PWM_PERIOD_TICKS);

    for (int i = 0; i < 4; i++) {
        g_motor_ctrl.motors[i].target_speed = 0.0f;
        g_motor_ctrl.motors[i].current_speed = 0.0f;
        g_motor_ctrl.motors[i].pwm_duty = 0;
        g_motor_ctrl.motors[i].stagger_delay_ms = 0;
    }
    g_motor_ctrl.overall_throttle = 0.0f;
    g_motor_ctrl.estop_active = true;
    g_motor_ctrl.state = MOTOR_STATE_ESTOP;
}

void Motor_ResetFault(void)
{
    g_motor_ctrl.estop_active = false;
    g_motor_ctrl.fault_detected = false;
    g_motor_ctrl.fault_mask = 0;
    memset(g_motor_ctrl.fault_samples, 0, sizeof(g_motor_ctrl.fault_samples));
    Motor_Stop();
}

void Motor_SetMode(DriveMode_t mode)
{
    g_motor_ctrl.drive_mode = mode;
}

void Motor_SetInvert(uint8_t motor_id, bool invert)
{
    if (motor_id >= 1 && motor_id <= 4) {
        g_motor_ctrl.motors[motor_id - 1].invert_dir = invert;
    }
}

bool Motor_GetInvert(uint8_t motor_id)
{
    if (motor_id >= 1 && motor_id <= 4) {
        return g_motor_ctrl.motors[motor_id - 1].invert_dir;
    }
    return false;
}

/**
 * @brief  Mecanum Inverse Kinematics Solver
 * @param  throttle: Forward/Backward velocity (-100% to +100%)
 * @param  steer: Yaw / rotational velocity   (-100% to +100%)
 * @param  strafe: Lateral strafe velocity    (-100% to +100%)
 */
void Motor_SetDrive(float throttle, float steer, float strafe)
{
    if (g_motor_ctrl.state == MOTOR_STATE_FAULT) {
        Motor_ResetFault();
    }
    if (g_motor_ctrl.estop_active) {
        return;
    }

    g_motor_ctrl.overall_throttle = fabsf(throttle);
    g_motor_ctrl.overall_steer = steer;
    g_motor_ctrl.overall_strafe = strafe;

    float fl, fr, rl, rr;

    if (g_motor_ctrl.drive_mode == DRIVE_MODE_RACECAR && strafe == 0.0f) {
        /* Standard differential race car steering */
        fl = throttle + steer;
        fr = throttle - steer;
        rl = throttle + steer;
        rr = throttle - steer;
    } else {
        /* Full 4-wheel Mecanum Holonomic Kinematics */
        fl = throttle + strafe + steer;
        fr = throttle - strafe - steer;
        rl = throttle - strafe + steer;
        rr = throttle + strafe - steer;
    }

    /* Normalization: prevent clipping if sum exceeds 100% */
    float max_val = fabsf(fl);
    if (fabsf(fr) > max_val) max_val = fabsf(fr);
    if (fabsf(rl) > max_val) max_val = fabsf(rl);
    if (fabsf(rr) > max_val) max_val = fabsf(rr);

    if (max_val > 100.0f) {
        float scale = 100.0f / max_val;
        fl *= scale;
        fr *= scale;
        rl *= scale;
        rr *= scale;
    }

    float m[4] = {
        Motor_Clamp(fl, -100.0f, 100.0f),
        Motor_Clamp(fr, -100.0f, 100.0f),
        Motor_Clamp(rl, -100.0f, 100.0f),
        Motor_Clamp(rr, -100.0f, 100.0f)
    };

    bool all_at_rest = true;
    for (int i = 0; i < 4; i++) {
        if (fabsf(g_motor_ctrl.motors[i].current_speed) > 1.0f ||
            fabsf(g_motor_ctrl.motors[i].target_speed) > 1.0f) {
            all_at_rest = false;
            break;
        }
    }

    uint32_t stagger_idx = 0;
    for (int i = 0; i < 4; i++) {
        g_motor_ctrl.motors[i].target_speed = m[i];
        if (all_at_rest && fabsf(m[i]) > 1.0f) {
            g_motor_ctrl.motors[i].stagger_delay_ms = stagger_idx * MOTOR_START_STAGGER_MS;
            stagger_idx++;
        }
    }

    /* Auto-enable if drive is requested while the bridges are idle or braked */
    if (g_motor_ctrl.state != MOTOR_STATE_RUNNING &&
        (fabsf(fl) > 1.0f || fabsf(fr) > 1.0f || fabsf(rl) > 1.0f || fabsf(rr) > 1.0f)) {
        Motor_Start();
    }
}

void Motor_SetIndividual(uint8_t motor_id, float speed_percent)
{
    if (g_motor_ctrl.state == MOTOR_STATE_FAULT) {
        Motor_ResetFault();
    }
    if (motor_id < 4 && !g_motor_ctrl.estop_active) {
        g_motor_ctrl.motors[motor_id].stagger_delay_ms = 0;
        g_motor_ctrl.motors[motor_id].target_speed = Motor_Clamp(speed_percent, -100.0f, 100.0f);
    }
}

/**
 * @brief  Acceleration / Deceleration S-ramp filter update (called every 1 ms)
 */
void Motor_UpdateRamp(uint32_t delta_ms)
{
    if (g_motor_ctrl.estop_active) {
        return;
    }

    /* Check driver fault lines (EN/nFAULTx held low by an enabled bridge) */
    if (Motor_CheckDriverFault(delta_ms)) {
        g_motor_ctrl.fault_detected = true;
        Motor_EmergencyStop();
        g_motor_ctrl.estop_active = false; /* Fault auto-recovers on next command; only ESTOP latches */
        g_motor_ctrl.state = MOTOR_STATE_FAULT;
        return;
    }

    float accel_step = MOTOR_RAMP_STEP_PER_MS * (float)delta_ms;
    float decel_step = MOTOR_RAMP_DOWN_STEP_PER_MS * (float)delta_ms;
    bool all_stopped = true;

    for (int i = 0; i < 4; i++) {
        if (g_motor_ctrl.motors[i].stagger_delay_ms > 0) {
            if (delta_ms >= g_motor_ctrl.motors[i].stagger_delay_ms) {
                g_motor_ctrl.motors[i].stagger_delay_ms = 0;
            } else {
                g_motor_ctrl.motors[i].stagger_delay_ms -= delta_ms;
                all_stopped = false;
                continue;
            }
        }

        float target = g_motor_ctrl.motors[i].target_speed;
        float current = g_motor_ctrl.motors[i].current_speed;
        float diff = target - current;
        bool accelerating = (fabsf(target) > fabsf(current)) && (target * current >= 0.0f);
        float max_step = accelerating ? accel_step : decel_step;

        if (fabsf(diff) <= max_step) {
            g_motor_ctrl.motors[i].current_speed = target;
        } else if (diff > 0.0f) {
            g_motor_ctrl.motors[i].current_speed += max_step;
        } else {
            g_motor_ctrl.motors[i].current_speed -= max_step;
        }

        if (fabsf(g_motor_ctrl.motors[i].current_speed) > 0.01f || fabsf(target) > 0.01f) {
            all_stopped = false;
        }

        Motor_ApplyPWMAndDirection(i, g_motor_ctrl.motors[i].current_speed);
    }

    /* Idle with every wheel ramped down: put the bridges back in high-Z */
    if (g_motor_ctrl.state == MOTOR_STATE_IDLE && all_stopped && g_motor_ctrl.bridges_enabled) {
        Motor_SetBridgesEnabled(false);
    }
}

static void Motor_ApplyPWMAndDirection(uint8_t id, float speed)
{
    float abs_speed = fabsf(speed);
    uint8_t dir = (speed >= 0.0f) ? 1 : 0;
    if (g_motor_ctrl.motors[id].invert_dir) {
        dir = dir ? 0 : 1;
    }
    uint32_t duty = 0;

    if (abs_speed < MOTOR_DEADBAND_PERCENT) {
        duty = 0;
    } else {
        duty = (uint32_t)((abs_speed / 100.0f) * (float)MOTOR_PWM_PERIOD_TICKS);
        if (duty > MOTOR_PWM_MAX_DUTY) {
            duty = MOTOR_PWM_MAX_DUTY;
        }
    }

    g_motor_ctrl.motors[id].pwm_duty = duty;
    g_motor_ctrl.motors[id].direction = dir;

    GPIO_PinState pin_state = (dir == 1) ? GPIO_PIN_SET : GPIO_PIN_RESET;

    switch (id) {
        case 0: /* Front Left (PWM Mode 1) */
            HAL_GPIO_WritePin(MOTOR1_DIR_GPIO_PORT, MOTOR1_DIR_PIN, pin_state);
            __HAL_TIM_SET_COMPARE(&htim3_motors, MOTOR1_PWM_CHANNEL, duty);
            break;
        case 1: /* Front Right (PWM Mode 2 phase-interleaved) */
            HAL_GPIO_WritePin(MOTOR2_DIR_GPIO_PORT, MOTOR2_DIR_PIN, pin_state);
            __HAL_TIM_SET_COMPARE(&htim3_motors, MOTOR2_PWM_CHANNEL, MOTOR_PWM_PERIOD_TICKS - duty);
            break;
        case 2: /* Rear Left (PWM Mode 1) */
            HAL_GPIO_WritePin(MOTOR3_DIR_GPIO_PORT, MOTOR3_DIR_PIN, pin_state);
            __HAL_TIM_SET_COMPARE(&htim3_motors, MOTOR3_PWM_CHANNEL, duty);
            break;
        case 3: /* Rear Right (PWM Mode 2 phase-interleaved) */
            HAL_GPIO_WritePin(MOTOR4_DIR_GPIO_PORT, MOTOR4_DIR_PIN, pin_state);
            __HAL_TIM_SET_COMPARE(&htim3_motors, MOTOR4_PWM_CHANNEL, MOTOR_PWM_PERIOD_TICKS - duty);
            break;
        default:
            break;
    }
}

MotorState_t Motor_GetState(void)
{
    return g_motor_ctrl.state;
}

float Motor_GetThrottle(void)
{
    return g_motor_ctrl.overall_throttle;
}

float Motor_GetMotorSpeed(uint8_t motor_id)
{
    if (motor_id < 4) {
        return g_motor_ctrl.motors[motor_id].current_speed;
    }
    return 0.0f;
}

bool Motor_IsFaultActive(void)
{
    return g_motor_ctrl.fault_detected;
}

uint8_t Motor_GetFaultMask(void)
{
    return g_motor_ctrl.fault_mask;
}

static float Motor_Clamp(float val, float min_val, float max_val)
{
    if (val < min_val) return min_val;
    if (val > max_val) return max_val;
    return val;
}
