nottysukku/GrassKit_Rover/17_Rover_MotorDriver_WiFi_ST67W61/firmware/Core/Inc/main.h

/**
  ******************************************************************************
  * @file           : main.h
  * @brief          : Header for main.c file.
  ******************************************************************************
  */

#ifndef __MAIN_H
#define __MAIN_H

#ifdef __cplusplus
extern "C" {
#endif

#include "stm32l0xx_hal.h"
#include "hardware_config.h"

void Error_Handler(void);

#ifdef __cplusplus
}
#endif

#endif /* __MAIN_H */
