nottysukku/GrassKit_Rover/17_Rover_MotorDriver_WiFi_ST67W61/firmware/Core/Inc/web_page.h

/* Rover control page, gzip-compressed (see web/make_page.py) */
#ifndef __WEB_PAGE_H
#define __WEB_PAGE_H

#include <stdint.h>

extern const uint8_t g_web_page_gz[];
extern const uint16_t g_web_page_gz_len;

#endif /* __WEB_PAGE_H */
