nottysukku/GrassKit_Rover/(commit log)

2026-10-12 Import RaceCar motor driver / Bluetooth / audio project
    Snapshot of the NUCLEO-L073RZ race car demonstrator as it stood before the
    BLE advertising fix: firmware, hardware docs and PC/phone controller tools.
    Unused ST vendor bulk (CMSIS docs/DSP/Lib/NN/RTOS, .chm) and build outputs
    are left out via .gitignore.
2026-10-12 Drop audio engine, align RBT01 pin map with ST UM3482, add web serial controller
    - Remove the audio engine module and its docs
    - Rework hardware_config / motor_control for the X-STM32MP-RBT01 CN2 pinout
    (PWM + direction + open-drain EN/nFAULT per bridge) as given in ST UM3482
    and the STSPIN948 datasheet
    - Rewrite the BlueNRG Bluetooth transport and extend the command parser
    - Update wiring, pinout and block-diagram docs to match
    - Add tools/web_serial_server.py and its preview launch config
2026-10-12 Add vendor documentation PDFs in numbered reading order
    43 PDFs under documentation/, grouped into nine numbered folders: the
    X-STM32MP-RBT01 board, its STSPIN948 driver, the NUCLEO-L073RZ and its MCU,
    the X-NUCLEO-IDB05A2 Bluetooth shield, the RBT01's on-board sensors, the
    firmware toolchain, ST's material on using the RBT01 with an STM32MP Linux
    host, and SLAM. documentation/README.md indexes each file with its ST
    document number and revision.
2026-11-04 Add Wi-Fi rover build, chassis model, final BOM and updated review deck
    - 17_Rover_MotorDriver_WiFi_ST67W61: NUCLEO-L073RZ + X-NUCLEO-67W61M1 +
    X-STM32MP-RBT01 firmware (SoftAP control page, safety watchdog), wiring
    docs, NCP bridge and host tools
    - 18_Rover_Chassis_OpenSCAD: parametric chassis and cutter model with a
    weight, centre-of-gravity, torque and battery report
    - documentation/00_Project_Status: status PDF and its generator, final
    two-rover BOM (70 lines with order links and design calculations), and
    the IRIS 7.0 deck with slides answering the 28 Oct review feedback
    - 16_RaceCar: per-wheel direction invert (INVERT:n) and staggered motor
    start-up; web serial server update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
2026-11-05 Add v1 printed chassis for the bench rover and the RBT01A build sheet
    - 18_Rover_Chassis_OpenSCAD/v1_3d_print_Chassis: one-piece printed deck
    for the parts on hand (NUCLEO-L073RZ + X-NUCLEO-67W61M1, X-STM32MP-RBT01,
    4 TT gear motors, mecanum wheels, 4 x 18650 and 2 x 2 AA holders),
    with the OpenSCAD model, deck and spacer STLs, renders and a README
    - 17_Rover_MotorDriver_WiFi_ST67W61/docs: RBT01A soldering and wiring
    build sheet (generator, HTML pages, two PNG sheets)
    - 18_Rover_Chassis_OpenSCAD: v3 enclosed chassis for the final BOM with
    STLs and renders, v2 kept in v2_first_parts_list/, v1 open-frame model
    - documentation/00_Project_Status: updated final BOM and review deck
    Co-A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
